CaptnSisko/CHARM/notebooks/trevor/README.md

# Lab Notebook

Trevor Wong (txwong2)

## Structure

This markdown file represents a summary of the work I've completed for this project. Each of the sections below represent a notebook entry. Based on the [online rubric](https://courses.physics.illinois.edu/ece445/guidelines/lab-notebook.asp), each entry must contain the following:

1. Date
2. Brief statement of objectives for session
3. Record of what was done

## 2022.08.23

We had our first group meeting. Our goal was to brainstorm ideas and come up with a high-level project idea that would be fun, useful, and fulfill the class requirements.

We came up with the idea of a drone-deployable mesh network and wrote a [post](https://courses.physics.illinois.edu/ece445/pace/view-topic.asp?id=71252) about it. We explored related research papers ([1](https://www.researchgate.net/publication/324776287_Drone_Based_Wireless_Mesh_Network_for_DisasterMilitary_Environment
) [2](https://ieeexplore.ieee.org/document/8796743)) and existing products ([1](https://www.iwtwireless.com/en-us/markets/tunneling/mine-rescue) [2](https://gotenna.com/blogs/newsroom/helitracking-connects-french-search-and-rescue-team-members-using-gotenna-mesh)), but these solutions were either much more expensive than our proposed design or did not offer the same set of features.

## 2022.08.25

We had our second group meeting to discuss design details and assign specific tasks.

After the meeting, we assigned further research as follows:
 - Mellisa: Sensors
 - Trevor: Battery Management
 - Martin: Routing

For the rest of the day and part of the next day, I researched requirements for the BMS and how I could implement it. I found the following components that could be useful in our design:

- [Batteries](https://liionwholesale.com/collections/batteries/products/protected-f1l-3350mah-li-ion-18650-button-top-battery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) - These batteries are cost effective li-ion cells from a reputable seller that include a built-in protection circuit. While the protected cells are longer than normal ones, we should be able to integrate clips to the PCB that accomodate them.
- [Charging IC](https://ww1.microchip.com/downloads/aemDocuments/documents/APID/ProductDocuments/DataSheets/21823D.pdf) - This is a popular, safe, and widely-used charge controller for LiPo and LIon batteries. An integrated controller like this is likely lot safer than a custom solution, especially considering the time constraints of our project.
- [Buck converter IC](https://datasheet.lcsc.com/lcsc/1810262207_XI-AN-Aerosemi-Tech-MT2492_C89358.pdf) - I researched some other voltage regulators, but they did not provide sufficient current for our design. A buck converter would probably be the best way to provide 3.3v regulation from the battery output, and this IC seems like it would be fairly easy to implement.
- [Boost converter IC](https://datasheet.lcsc.com/lcsc/1811151539_XI-AN-Aerosemi-Tech-MT3608_C84817.pdf) - We would also need a boost converter to convert the 5v USB input to the 12v needed to charge the batteries.

This [blog post](https://circuitdigest.com/electronic-circuits/designing-an-advance-2s-li-ion-li-po-battery-charger-system-using-mcp73844-ic) was helpful in coming up with battery design ideas and learning more about battery charging.

Overall, these ICs all have reference designs in their datasheet that we can adapt to our needs. We will need to carefully design our PCBs to follow the guidelines layed out in the datasheet, provide decoupling and filtering components as necessary, and minimize wasted space. We also need to consider the easy of assembly, since we will likely be soldering these by hand. I summarized my findings in our draft of the RFA.

## 2022.08.26

We had another meeting today with the goal of finalizing and submitting the RFA.

We reviewed our individual work and collaboratively submitted an RFA.

## 2022.08.29

We had a meeting to discuss next steps.

We decided to begin delagating tasks and decided to start working on the monitoring frontend / backend, since that part of our project is largely independent of hardware. I was assigned to create a task board in Github, write boilerplate code for our frontend / API, and set up the cloud infrastructure.

## 2022.08.30

Today I worked on setting up the cloud infrastructure for my team.

For the frontend, I created a react template using `create-react-app`. Next, I set up a project on [Netlify](https://www.netlify.com/). I was already failiar with this CI/hosting platform, and it seemed like the easiest way to deploy our frontend for free. The biggest challenge I ran into was figuring out how to configure the automatic deployment. Considering the master branch might have a large number of commits that don't relate to the frontend, I decided to create a `client-deploy` branch specifically for the netlify integration. Now, to deploy the frontend, we simply open a pull request to the `client-deploy` branch. Netlify automatically generates a preview and publishes the changes to production when we approve the pull request. Netlify can also store secrets such as API keys as environment variables. This will be useful for interacting with Google maps.

For the backend, we decided to use an [AWS Lightsail](https://aws.amazon.com/lightsail/) instance. I installed NodeJS, MariaDB, Nginx, and LetsEncrypt and wrote some sample code to make sure the server worked. I added all team members' SSH keys.

## 2022.09.02

Today we had a team meeting to discuss progress and assign more tasks. 

## 2022.09.03 - 2022.09.05

Over the long weekend, I worked on the schematic for our nodes. The overall node design is split into 2 parts, each of which contain multiple submodules:

Charging circuit: `USB-C Charger input (5v) -> boost converter (9.6v) -> battery charger`

Omega2S circuit: `battery output (~7.4v) -> buck converter (3.3v) -> Omega2 and sensors`

There's a switch between the battery output and Omega2S circuit to allow the user to turn the device off when it is not in use or charging.

### Schematic

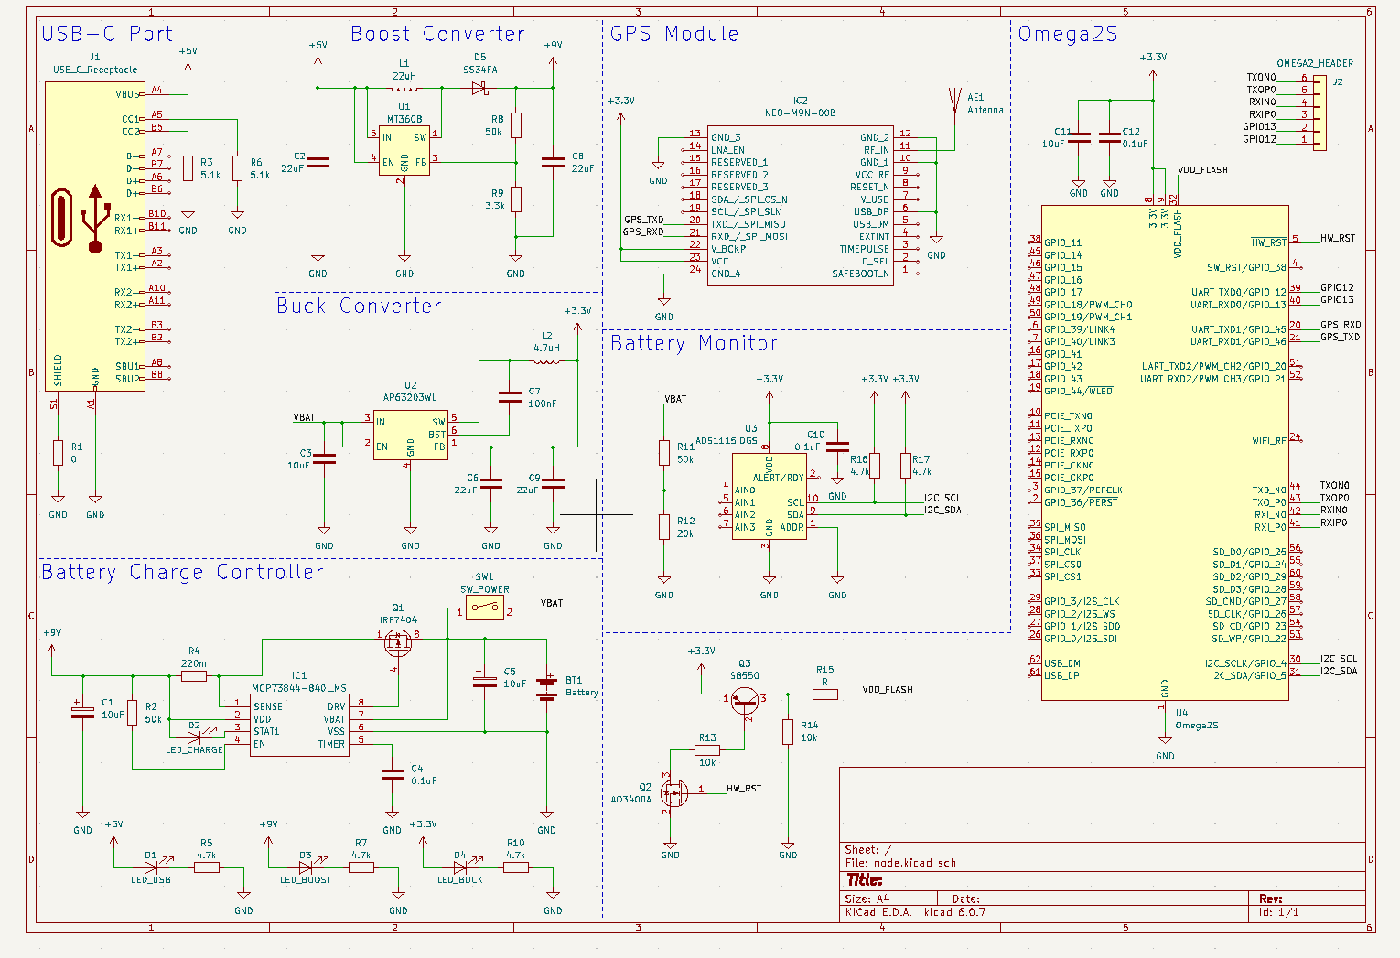
[picture p5: notebooks/trevor/images/draft1_schem.png]
CHARM Schematic


Notes on each component:

### USB-C Port

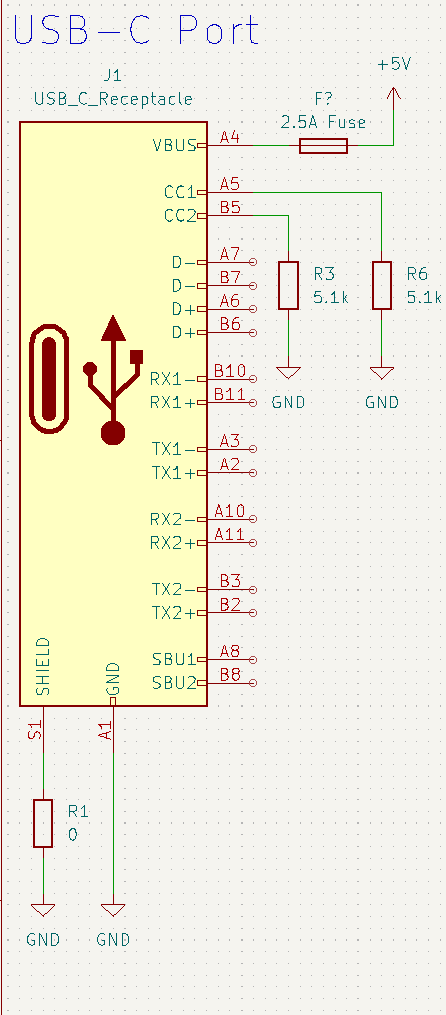
[picture p6: notebooks/trevor/images/draft1_usb.png]
CHARM Schematic USB-C USB-C Schematic


- Biggest challenges are power negotiation and soldering a 24-pin usb-c connector
- [It's possible to draw power from USB-C without negotiating on the CC pins with only two resistors](https://forum.digikey.com/t/simple-way-to-use-usb-type-c-to-get-5v-at-up-to-3a-15w/7016), which is by far the easiest and cheapest way to implement USB-C power delivery
- Our design is unlikely to draw 3 amps of power
- The tradeoff is that users with unsupported/legacy usb chargers may experience issues, and our design should only be used with usb power supplies that support at least 2.4 amps at 5 volts
- A fuse helps to mitigate safety hazards from accidental short circuits or other malfunctions causing current to be overdrawn
- For ease of soldering, CUI devices has [power-only USB-C connectors](https://www.mouser.com/pdfDocs/intro-to-power-only-usb-type-c_mouser.pdf) with fewer pins
- There are [mixed messages](https://electronics.stackexchange.com/questions/389972/usb-shield-to-ground-or-not-to-ground) about whether to ground the USB sheild, so a 0Ω resistor will allow us to change it either way as needed

### Boost Converter

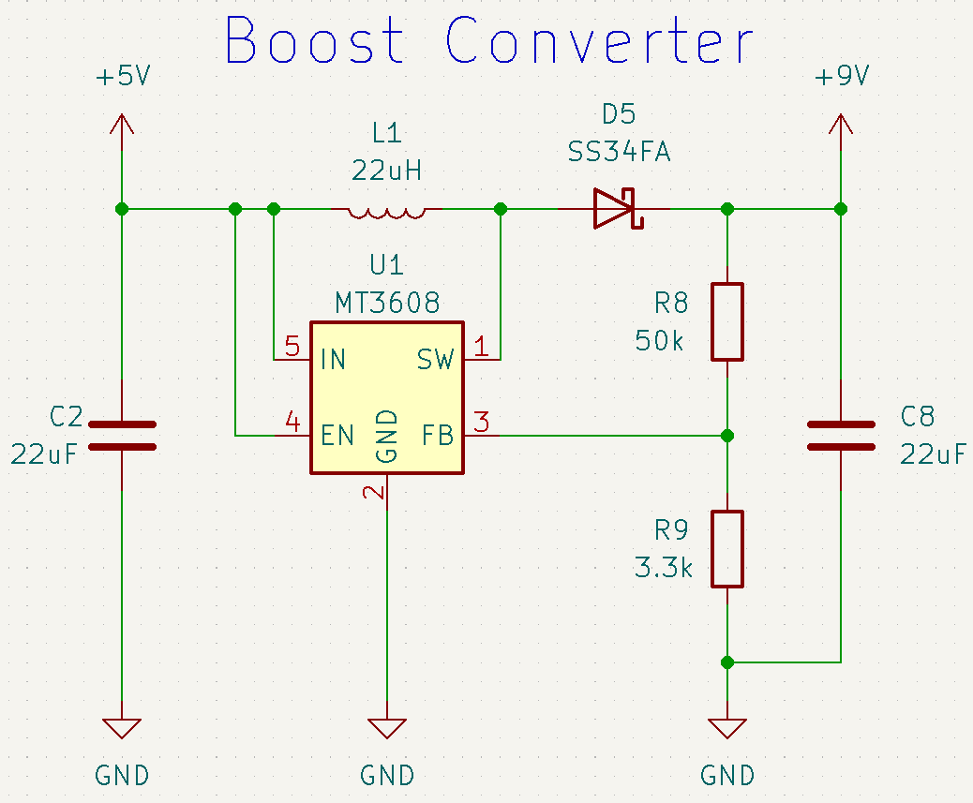
[picture p7: notebooks/trevor/images/draft1_boost.png]
CHARM Schematic Boost Converter Boost Converter Schematic

- MT3608 is an extremely popular boost converter, having been used in this [blog post](https://circuitdigest.com/electronic-circuits/designing-an-advance-2s-li-ion-li-po-battery-charger-system-using-mcp73844-ic) referenced earlier and many [cheap 2A boost converters on Amazon](https://www.amazon.com/Converter-Adjustable-Voltage-Regulator-Compatible/dp/B089JYBF25)
- The biggest change to the "standard" design (aka the reference schematic in the datasheet with the components all the breakout board sellers use) is this one uses a fixed resistor instead of a potentiometer for R8
- A fixed resistor lowers cost and footprint
- As long as the output voltage stays between 8.7 and 12, it is in spec as the input for the battery charge controller, which is all that really matters. This is such a wide range that a potentiometer for percise control is not needed

According to the MT3608 datasheet, the formula for output voltage is 

`Vout = Vref * (1 + R8/R9)`

Vref is typically 0.6V, with a range of 0.588V to 0.612V. If we use resistors with 1% tolerance, then R8 ranges from 49.5kΩ to 50.5kΩ and R9 ranges from 3.267kΩ to 3.333kΩ. Plugging these values in, we have

`min(Vout) = 0.588 * (1 + 49.5 / 3.333) = 9.32v`

`avg(Vout) = 0.6 * (1 + 50 / 3.3) = 9.69v`

`max(Vout) = 0.612 * (1 + 50.5 / 3.267) = 10.1v`

These are all within the acceptable range for our application. 

- The datasheet suggests using inductors from 4.7 to 22 uH. All the MT3608 boost converter breakout boards I've seen on [Aliexpress](https://www.aliexpress.com/wholesale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), Amazon, etc seem to use a 22 uH inductor, so I selected that value for the inductor 
- The datasheet suggests 22uF capacitors with low ESR, specifically stating X5R and X7R types are preferred
- The datasheet suggests a Schottky diode with a referse breakdown voltage higher than the output voltage and a current rating determined by the formula as follows:
- This chip seems difficult to source standalone in the USA, although it is available on JLC PCB and AliExpress

`Id = sqrt(Iout * Ipeak)`

Iout = 0.5, which is the typical charge current for our battery
Ipeak = 2, which is the absolute maximum the battery charging circuit should draw

According to this formula, we should use Schottky diode with a rating of at least 1A. The [SS34](https://www.mouser.com/ProductDetail/onsemi-Fairchild/SS34FA?qs=R26iFe%2FkX%2FK1QUwZdCmBBw%3D%3D) is the most commonly used diode in the premade PCBs online, and this is rated for 3A of current, a 40V breakdown voltage, and a low forward voltage of 0.5V. The current rating might be overkill for our use case, so it might be worth considering alternatives such as the [SS22FA](https://www.mouser.com/ProductDetail/onsemi-Fairchild/SS22FA). It is unclear whether there are any major downsides to using a diode rated for a higher current than what is actually used, and selecting the most widely used component might be the safest option.

### Buck Converter

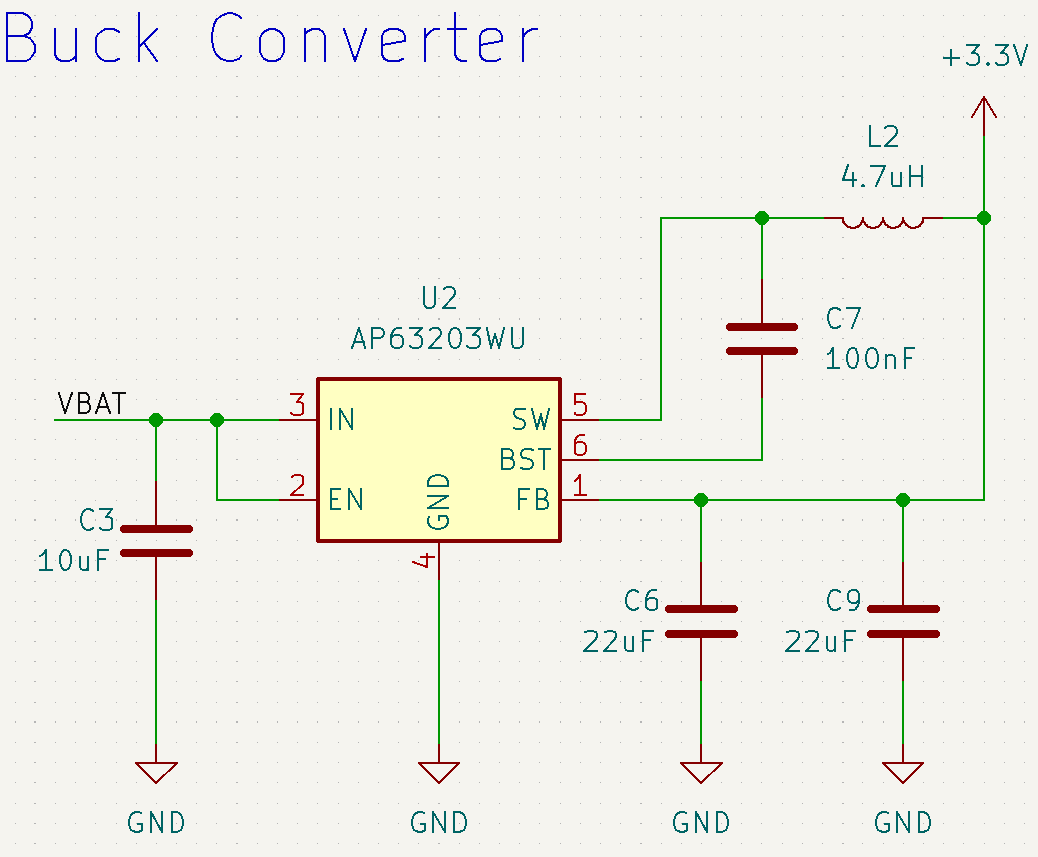
[picture p8: notebooks/trevor/images/draft1_buck.png]
CHARM Schematic Buck Converter Buck Converter Schematic


- A voltage regulator is needed to step down the battery voltage to 3.3V for the processor and sensors
- Linear voltage regulators are generally rated for 800mA or less, which would be enough for the Omega2S alone but not for also powering the GPS and ADC
- Using an external antenna on the GPS and Omega2S might also increase the power draw beyond what a linear regulator could provide
- An unstable 3.3v supply could cause reliability issues which are unacceptable in a search and rescue mission
- a buck converter can achieve higher efficiency and much higher current capacity
- the [AP63203WU](https://www.mouser.com/ProductDetail/Diodes-Incorporated/AP63203WU-7?qs=u16ybLDytRZ1JqxbuLkMJw%3D%3D) has an internal 3.3v reference voltage, so there is no need to set external resistor values like with the boost converter
- This buck converter can supply up to 2A, which is plenty
- the passive component selection and layout is identical to the reference schematic provided in the datasheet

### Battery Charge Controller

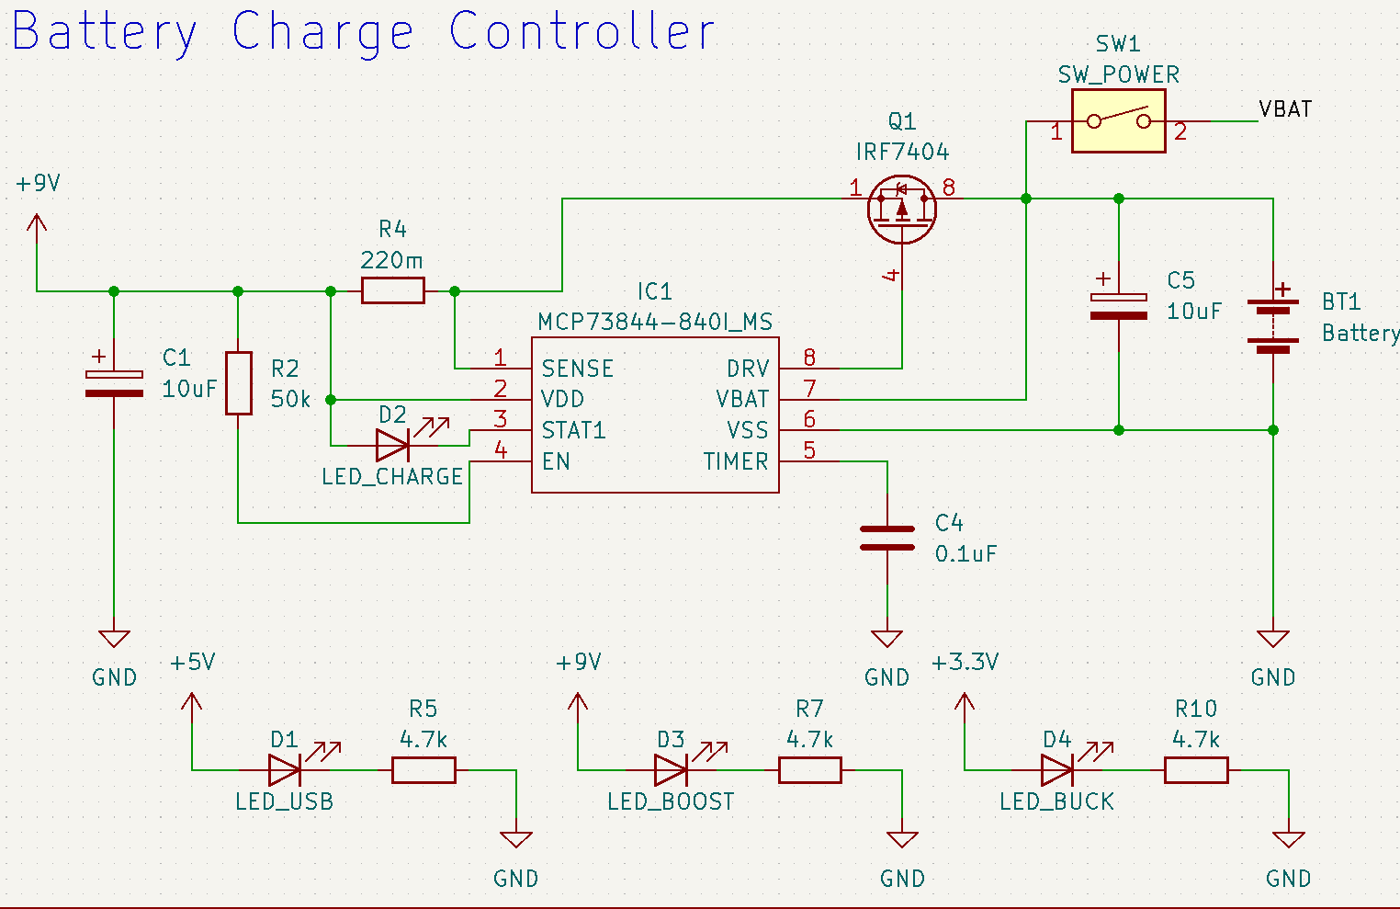
[picture p9: notebooks/trevor/images/draft1_bcc.png]
CHARM Schematic Battery Charge Controller Battery Charge Controller


- This implementation follows the reference schematic for the [MCP73844](https://www.mouser.com/ProductDetail/Microchip-Technology-Atmel/MCP73844-840I-MS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)
- This chip is specifically designed for 2s LiIon batteries with a maximum charge of 4.2V
- The NDS8434 and IRF7404 are both recommended as MOSFETS. The NDS8434 is not stocked on mouser, so I used IRF7404
- The datasheet recommends at least a 4.7uF tantalum or aluminum electrolytic capacitor at the power source and in parallel to the battery for up to 1A of charging current. 10uF allows for additional error margin, and it is the value used in the "typical application circuit" on the datasheet
- The enable pin simply needs to be pulled high, so the exact resistor value doesn't matter too much. 50k is used because it is already present in other parts of the design
- Arguably the most important passive component is the shunt resistor, as this determines the charge current. The datashee specifically recommends the ERJ-6RQFR22V 220 mΩ, 1%, 1/8W shunt resistor for approximately 500mA charging. The formula for the resistor value is as follows:

`Rsense = Vfcs/Ireg`

Vfcs is the Fast Charge Current Regulation Threshold, which ranges from 0.1v to 0.12v with a nominal value of 0.11v according to the datasheet.

Ireg is the desired charging current, in amps.

Since we want 500mA charging, Rsense = 0.11/0.5 = 0.22 or 220mΩ. Given the resistor has a 1% tolerance, we can also calculate the minimum and maximum charge current as follows:

`min(Ireg) = 0.1/0.2222 = 0.45 = 450mA`

`max(Ireg) = 0.12/0.2178 = 0.551 = 551 mA`

These are all acceptable currents for our application. Our batteries have 3400mAh of capacity, so a safe 1C charging speed would be anything up to 3.4 Amps of current. That said, it is important to limit the current to not overload the USB power source and allow for lower capacity batteries to be safely used.

The power dissapated over the resistor is given by

`P = R * I^2`

Given a worst case current of 551mA, the resistor disapates up to 66.8mW of heat, which is within spec of the suggestion above and a reasonable value.

This calculation matches that made in the datasheet, so their shunt resistor recommendation holds for our use case.

- A 0.1uF capacitor on the timer pin results sets the battery safety timers to their default value
- TODO: check if a larger capacitor is needed to increase the safety timers, since the cells we are using have such a high capacity that they will take over 3 hours to charge
- The schematic includes the status LED and also LEDs on the power rails that can double as test points

### GPS Module

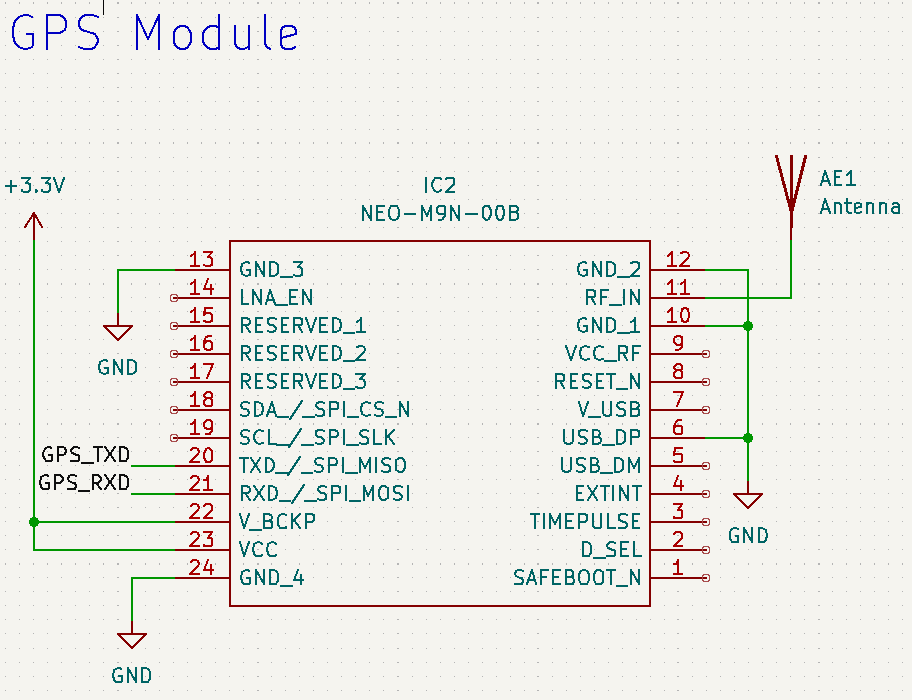
[picture p10: notebooks/trevor/images/draft1_gps.png]
CHARM Schematic GPS Module GPS Module


- The [NEO-M9N](https://www.u-blox.com/en/product/neo-m9n-module) GPS is one of the latest GPS modules from U-blox, with a high level of accuracy considering the cost
- It supports the standard NEMA protocol over UART
- Doesn't seem to have an antenna, so a port will need to be added to the PCB
- Sparkfun sells a [breakout board](https://www.sparkfun.com/products/15712) and a number of compatible [GPS antennas](https://www.sparkfun.com/search/results?term=U.FL+antenna). The breakout board schematic is open source, so it can be used for reference
- The implementation of this chip is extremely simple, with no required passive components other than an antenna
- TODO: figure out for sure whether it has a built in antenna
- TODO: does this need a decoupling capacitor or other passive components

### Battery Monitor

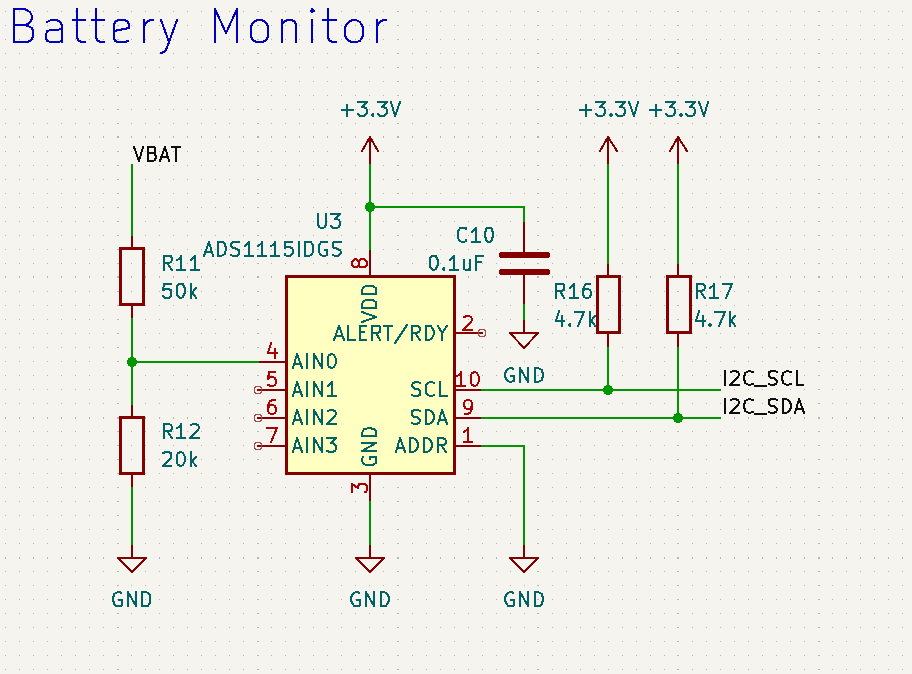
[picture p11: notebooks/trevor/images/draft1_bm.png]
CHARM Schematic Battery Monitor Battery Monitor


- The [ADS1115](https://www.ti.com/product/ADS1115) is the ADC used in the official breakout board for the Omega2, so it makes sense to use here
- According to the Omega2S docs, the I2C wires should both have 4.7k pullup resistors
- The dastasheet suggests a 0.1uF decoupling capacitor
- The battery voltage is sent through a voltage divider, since the analog voltage can only be read from GND-0.3 to VDD+0.3, which is -0.3v to 3.6v in this case
- With the voltage divider, a fully charged battery at 8.4 volts would read as 2.4v
- 50k resistor is used because it is present in other parts of the circuit, and high resistance minimizes wasted current

### Omega2S

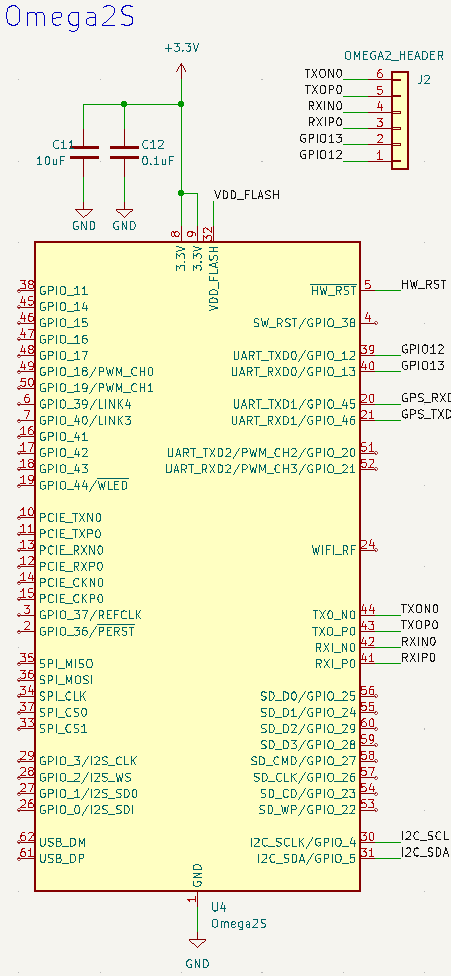
[picture p12: notebooks/trevor/images/draft1_omega.png]
CHARM Schematic Omega2S Omega2S


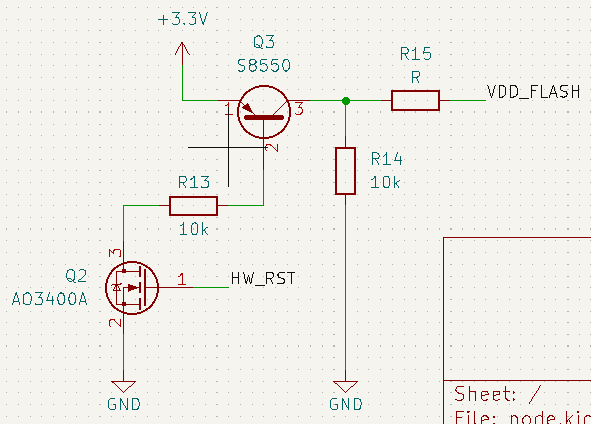
[picture p13: notebooks/trevor/images/draft1_omega_power.png]
CHARM Schematic Omega2S Omega2S


- Not much to say, this schematic is the suggested implementation from the [official hardware design guide](https://github.com/OnionIoT/Omega2/blob/master/Documents/Omega2S%20Hardware%20Design%20Guide.pdf)
- TODO: verify the test points can be used to flash the omega2 if it become currupted (doesn't it need a ground pin or something?)
- TODO: determine if we are using Omega2S or Omega2S+, which changes the power-on circuit
- TODO: determine if there are any more metrics that should be monitored by the ADC or if the device needs any other ports such as USB or Ethernet

## 2022.09.05

We had a meeting to discuss the current design and check the pricing and availability of the components.

It turns out many of the components in the design are out of stock or difficult to obtain in the USA. I was assigned the task of redoing the boost and buck converter with new ICs. The Omega2S is also being replaced with an Omega2+ to allow for a more modular design.

We found [this boost converter](https://www.mouser.com/ProductDetail/595-TPS61085TPWR) and [this voltage regulator](https://www.mouser.com/ProductDetail/595-TPS61085TPWR) that should be able to replace the out of stock parts.

## 2022.09.10

Today I am updating the circuit to only include in-stock ICs.

The [boost converter found in the last meeting](https://www.ti.com/product/TPS61085T) only supports 6v input, so I guess it's back to the drawing board. Looking online, I found a lot of boost converter PCBs use the [XL69019](http://www.xlsemi.com/datasheet/XL6019%20datasheet-English.pdf), but unfortunately this also has limited availability.

Using the [Texas Instruments webench tool](https://webench.ti.com/power-designer/) to design boost and buck converters. This took a long time, since I went through each passive component to find ones that were all in stock. Eventually, I was able to generate two schematics that worked for out design, and I transcribed them to KiCad as shown below:

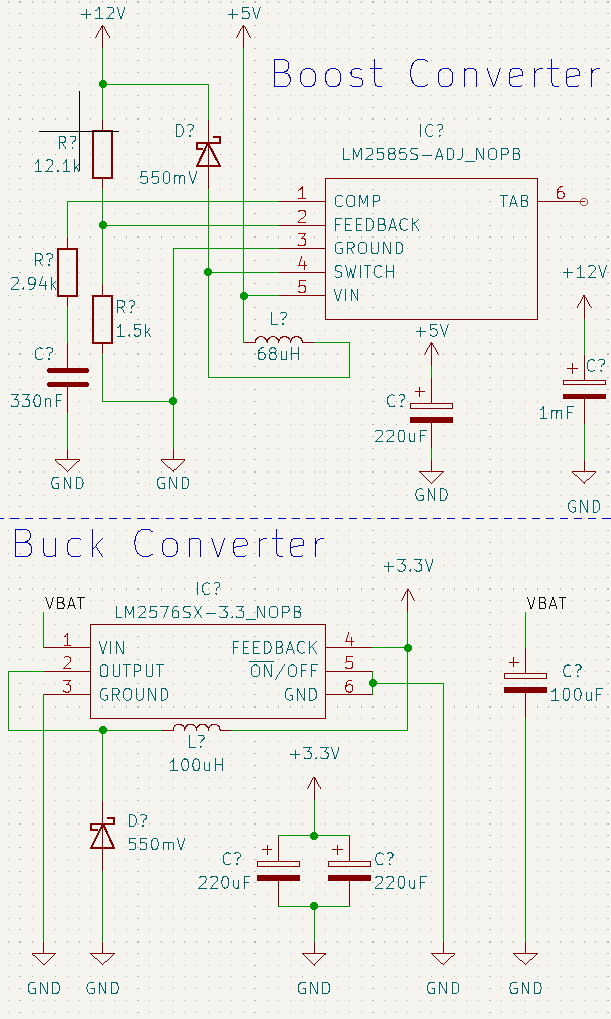
[picture p14: notebooks/trevor/images/instock_converter.png]
Updated Schematic Buck and boost converter


This design uses the [LM2576](https://www.ti.com/lit/ds/symlink/lm2576.pdf?ts=1662810343921) buck converter and [LM2585](https://www.ti.com/lit/ds/symlink/lm2585.pdf?ts=1662839934079) boost converter.

## 2022.09.10

This morning, I discovered TI had a fixed voltage output variant of the boost converter I was using.

I used the webench tool to help design a new boost converter with even lower BOM count, changing a few components to ensure each part was in stock on Mouser.

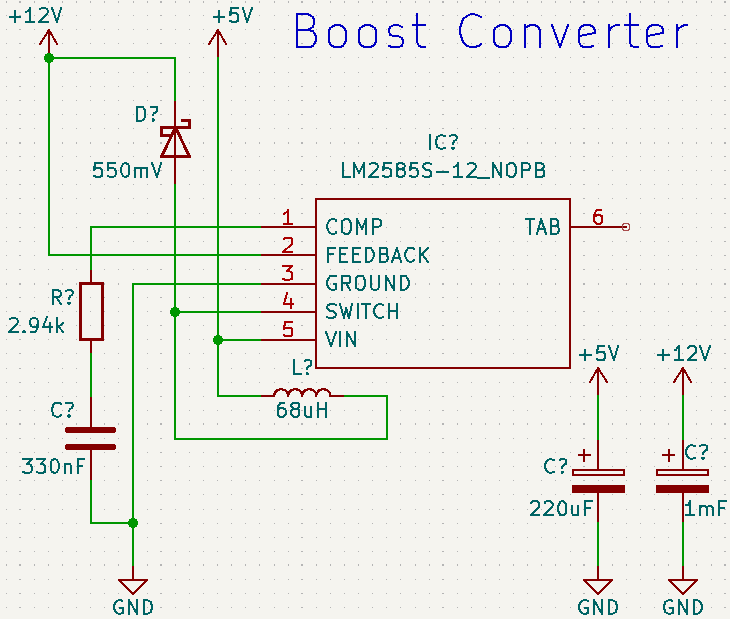
[picture p15: notebooks/trevor/images/updated_boost.png]
Low-part boost converter Boost converter


As shown, the design is largely unchanged, but there is no need for a voltage divider to provide feedback like there was before.

## 2022.09.13

Today, I am uploading the design reports I generated using the TI Webench tool a couple days ago.

[Boost Converter Design Report](files/Boost_Converter_Design_Report.pdf)

[Buck Converter Design Report](files/Buck_Converter_Design_Report.pdf)

## 2022.09.15

Today I finished and submitted my part of the proposal as well as revised my other teammates' sections. I mostly focused on power delivery. I also met with the machine shop with Melissa to discuss their role in the project. They are willing to pay for the PCB boxes and it won't be counted against our budget. 

## 2022.09.20 - 2022.09.25

This week, I continued double and triple checking the hardware schematic to ensure it would work when we ordered our first round of PCBs. The total BOM cost is fairly high for 5 nodes, so I wanted to make sure we would not waste our money on a bad board or incorrect components.

The biggest error in the schematic involved the UART port for the GPS. Specifically, the [Omega2S+ hardware design guide](https://github.com/OnionIoT/Omega2/blob/master/Documents/Omega2S%20Hardware%20Design%20Guide.pdf) requires the UART pins to be floating on bootup, which would not work with the GPS connected to these pins:

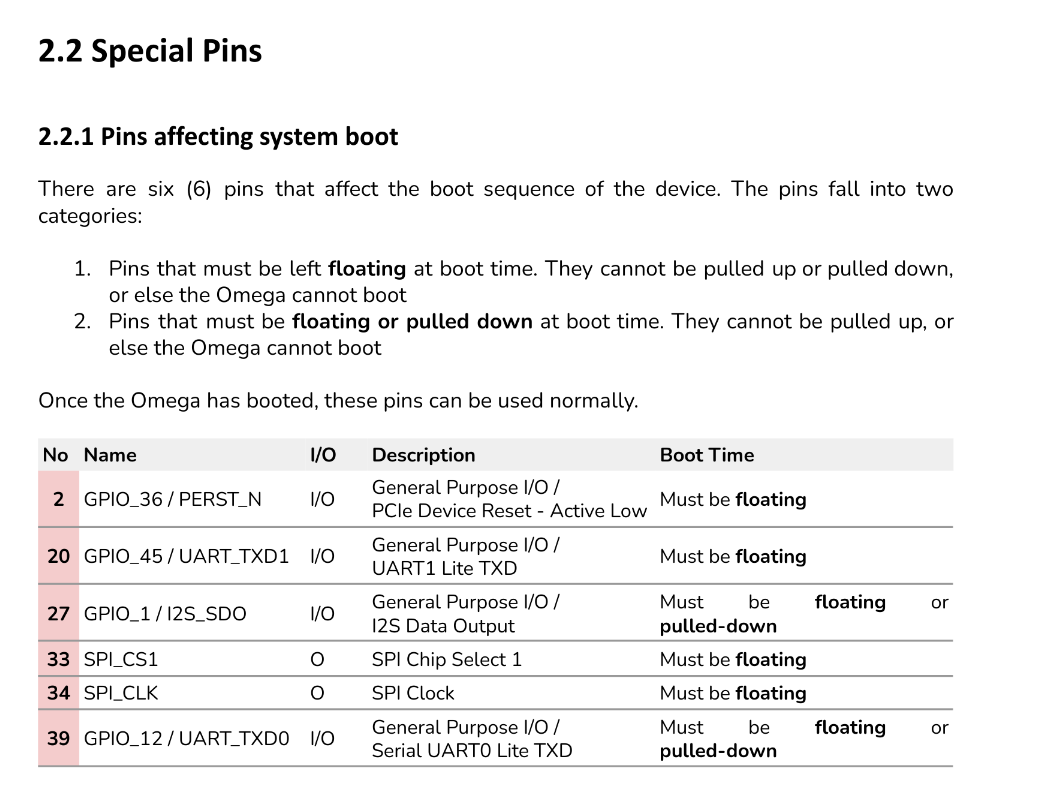
[picture p16: notebooks/trevor/images/revise_omega.png]
Omega Hardware Design Guide Floating UART


To fix this, I changed the GPS module to connect to the omega2s via USB. I also added series resistors on the data lines as specified in the GPS and Omega2S reference schematics.

I also revised the GPS antenna design to implement the bias-T circuit recommended in the hardware integration manual:

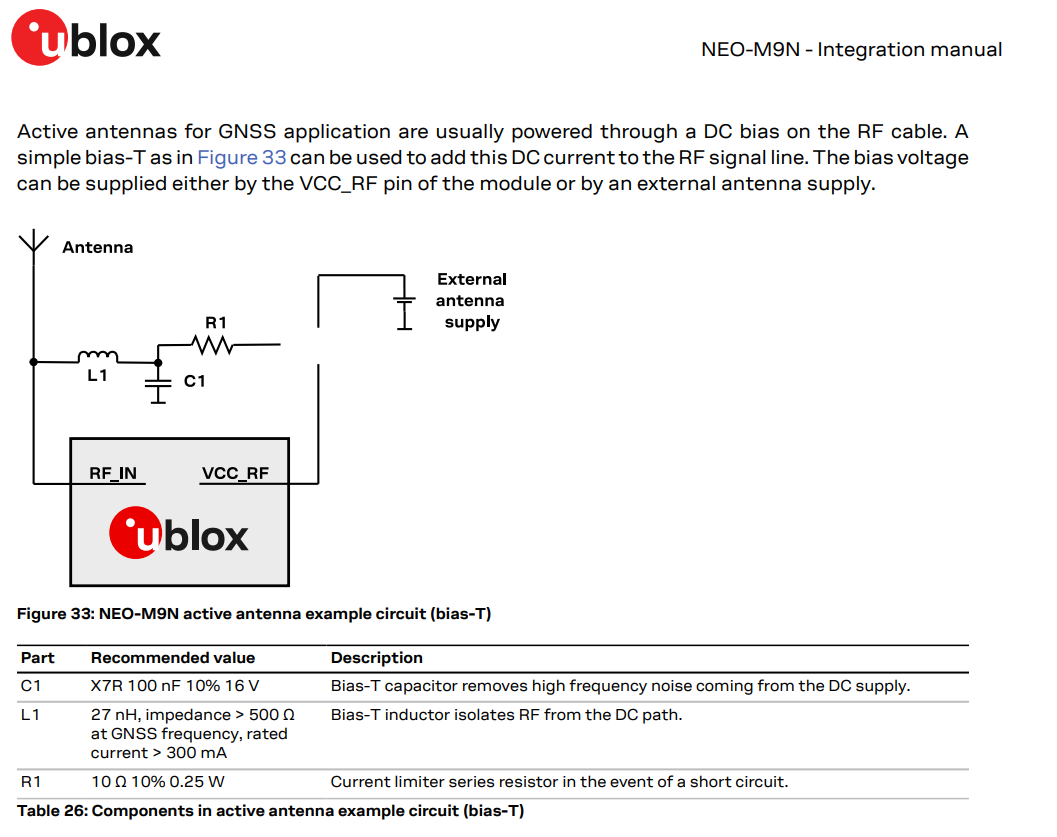
[picture p17: notebooks/trevor/images/revise_neo.png]
NEO-M9N Hardware Design Guide Active Antenna


I also added a decoupling capacitor and anti-ESD diode as recommended in the manual.

## 2022.09.27

I spent all day today going through every single schematic symbol, finding a compatible part on mouser, and assigning a footprint accordingly. When there was not a standard footprint available in Kicad I used [Component Search Engine](https://componentsearchengine.com/) to find footprints online. While there's not too much to say in the notebook, this was a long and tedious process.

## 2022.09.29 - 2022.10.4

I spend a few days completing the PCB layout and submitting the order to JLC PCB. Our design is too large for the course's 10cm by 10cm limit, and our TA advised us that the course PCB order would likely be delayed.

The submodules were arranged as follows:

### USB-C Port
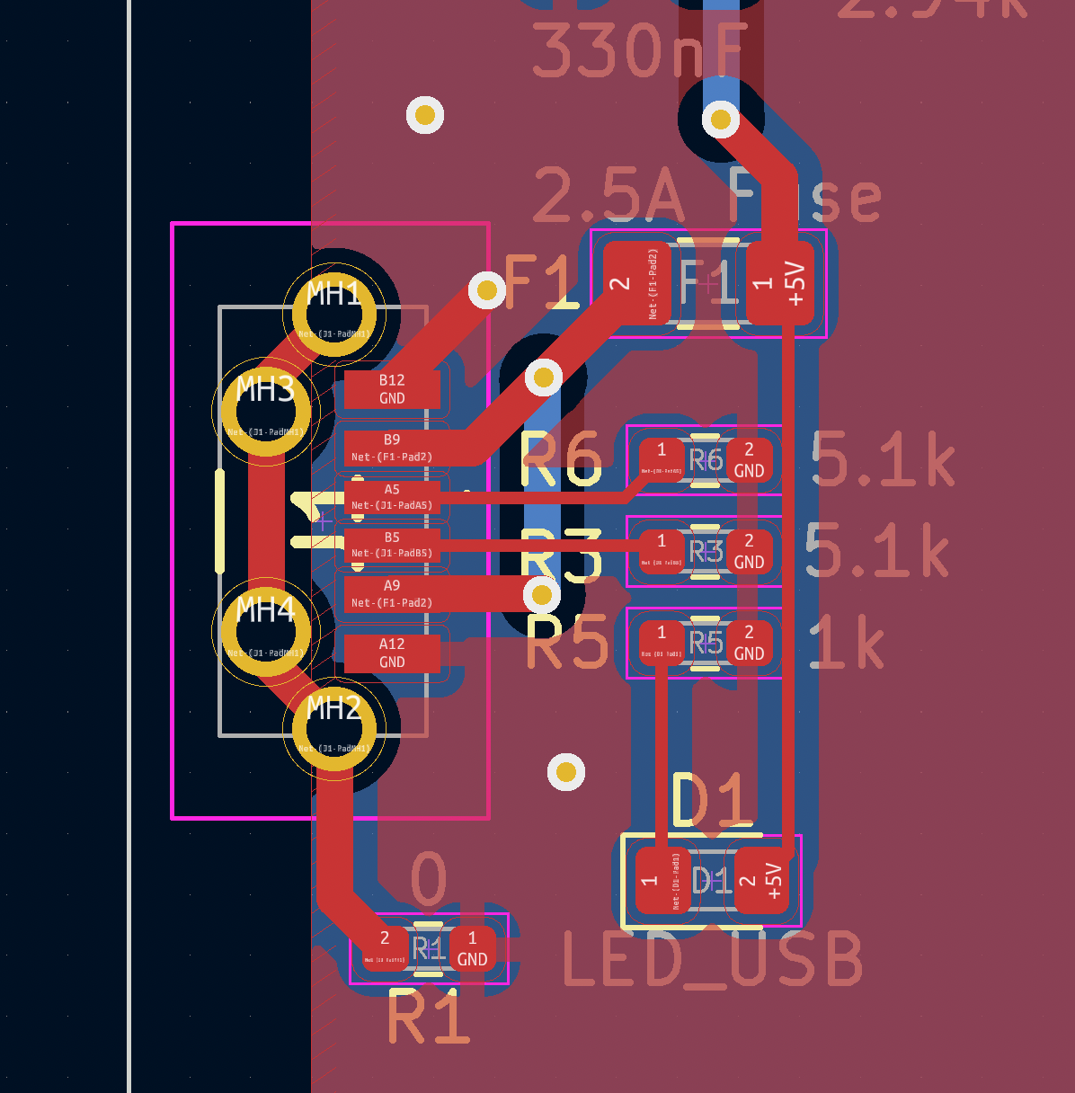
[picture p18: notebooks/trevor/images/layout1_usb.png]
CHARM Layout USB-C USB-C

Not to much to say about the USB-C layout. R1 will likely be left blank, but it can be easily added to ground the USB sheilding if needed. Large traces are used for 5v power delivery.

### Boost Converter

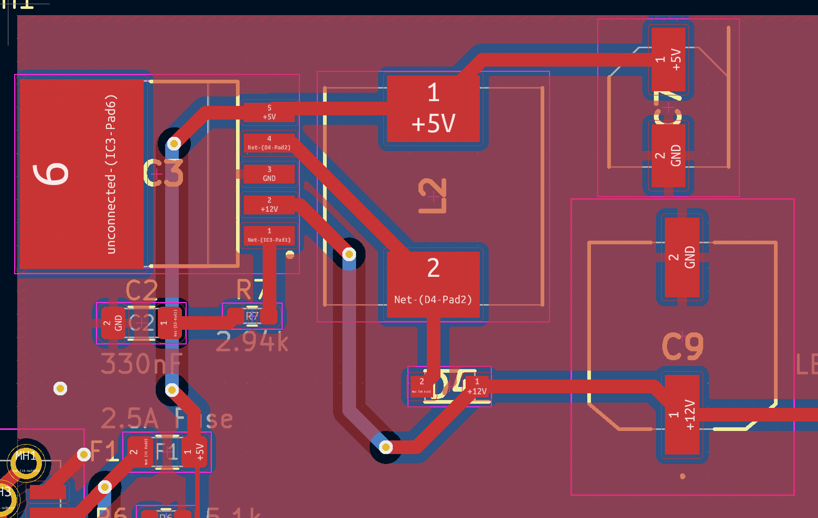
[picture p19: notebooks/trevor/images/layout1_boost.png]
CHARM Layout Boost Converter Boost Converter


This follows the recommended boost converter layout from the boost converter IC datasheet. Thick traces are used throughout since this is a power delivery circuit. 

### Battery Charge Controller

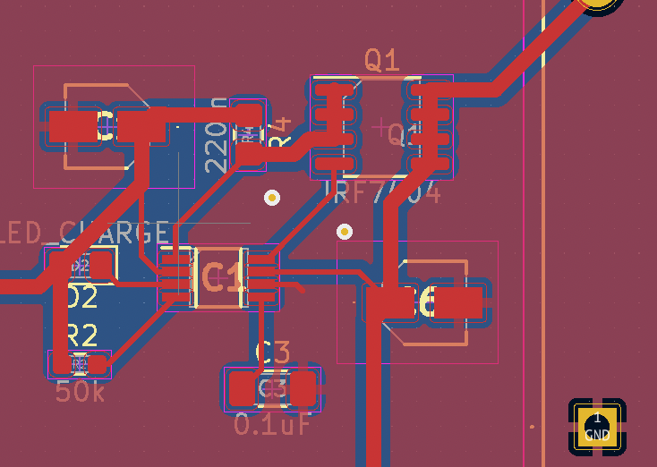
[picture p20: notebooks/trevor/images/layout1_bms.png]
CHARM Layout Battery Charge Controller Battery Charge Controller


This layout is similar to this [blog post](https://circuitdigest.com/electronic-circuits/). Large traces are used where the battery charging current is expected to flow. The pins on the battery charge controller are too narrow to use large traces everywhere.

### Buck Converter

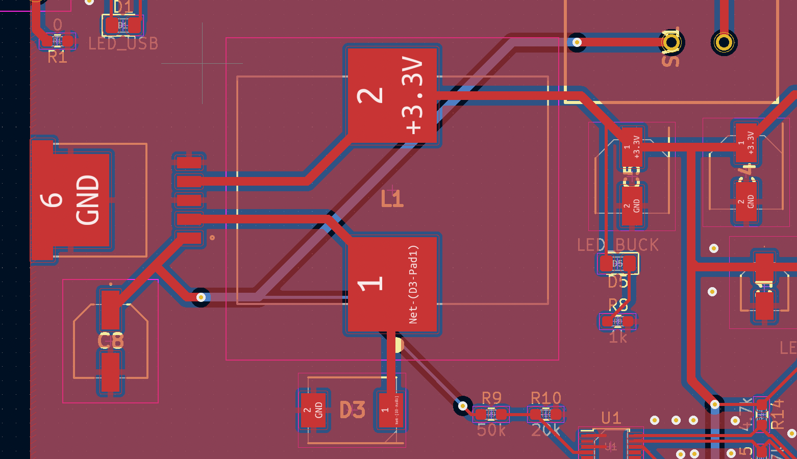
[picture p21: notebooks/trevor/images/layout1_buck.png]
CHARM Layout Buck Converter Buck Converter


This follows the recommended boost converter layout from the buck converter IC datasheet. Thick traces are used throughout since this is a power delivery circuit. I did not realize how large inductor L1 was until seeing its footprint. C4 and C5 are output decoupling capacitors for the buck converter, and other components on the right are for other subsystems.

### Omega2S

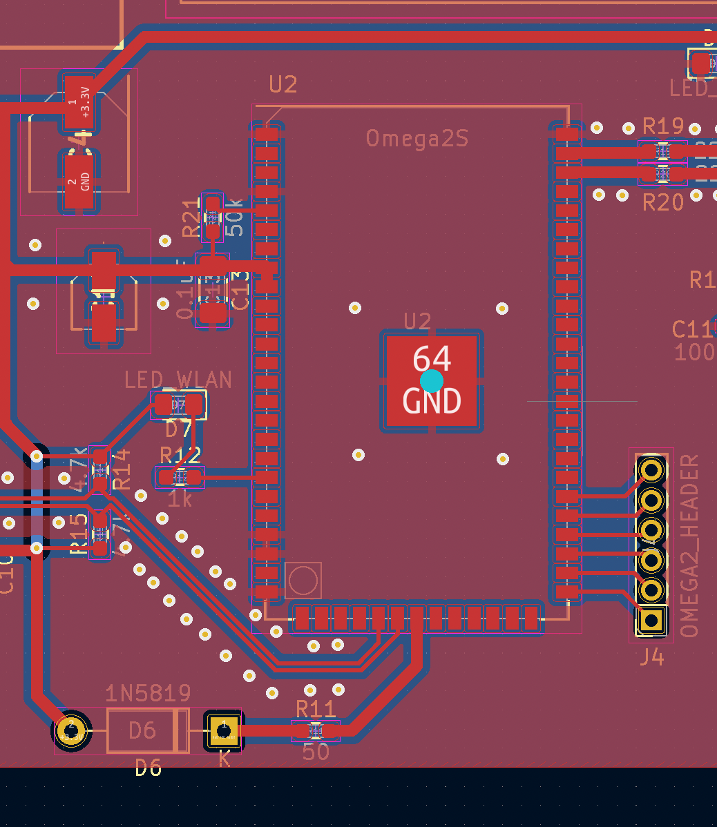
[picture p22: notebooks/trevor/images/layout1_omega.png]
CHARM Layout Omega2S Omega2S


The layout for the Omega2S is fairly simple, and most of my time was spent verifying which pins should be connected to power, pulled up, or grounded. There are two decoupling capacitors on the 3.3v rail, an exposed header for possible firmware flashing, and a diode for the flash power supply as specified in the [hardware design guide](https://github.com/OnionIoT/Omega2/blob/master/Documents/Omega2S%20Hardware%20Design%20Guide.pdf). Thick traces are used for power delivery.

### ADC

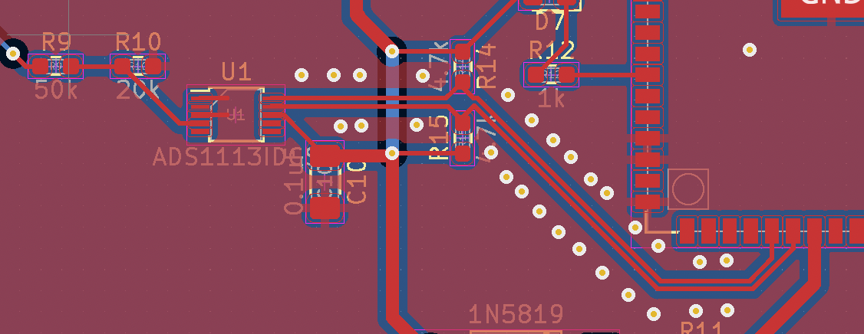
[picture p23: notebooks/trevor/images/layout1_adc.png]
CHARM Layout ADC Omega2S


The layout for the ADC includes the R9/R10 voltage divider, the C10 decoupling capacitor, and the R14/R15 pullup resistors. The data lines are impedance-matched by ensuring they are the same length and surrounded by ground vias to minimize signal noise. While this may be overkill for I2C, it is better to be safe than sorry.

### GPS

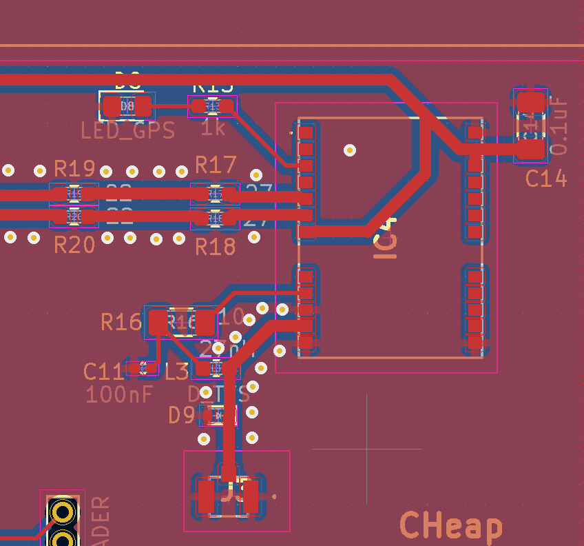
[picture p24: notebooks/trevor/images/layout1_gps.png]
CHARM GPS GPS


The GPS layout includes a decoupling capacitor, USB signal traces, and RF signal traces. The USB data lines have two sets of termination resistors, which are kind of silly but technically required to follow the reference schematic. Most likely, these will simply be populated with 0-ohm jumpers, but it is better safe than sorry. The bais-T circuit and ESD diode are on the bottom left. As recommended in the [NEO-M9N](https://www.u-blox.com/en/product/neo-m9n-module) design guide, the antenna trace is surrounded by grounding vias to minimize interference. The signal traces are thick to minimize impedance.

## 2022.10.15 - 2022.10.18

This weekend we soldered the first prototype PCB. Suprisingly, there is not much to say here, since all the subsystems worked as we tested them. There were a couple issues with the footprints and board dimensions, but overall we are quite happy with the PCB functionality.

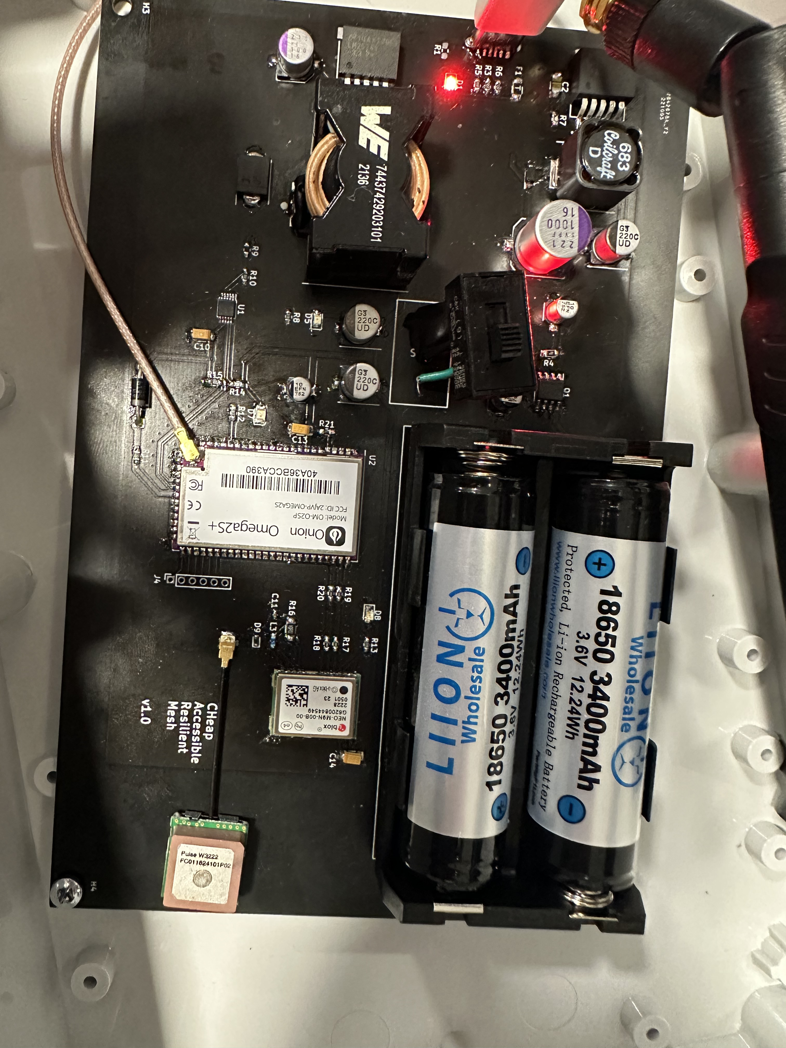
[picture p25: notebooks/trevor/images/pcb1_soldered.jpg]
CHARM PCB Revision 1 PCB Revision 1


### 2022.10.20

Today, I revised and ordered an updated PCB. The most visible change is the overall design, which now has rounded corners, rounded sides, and stylistic / weight saving triangle cutouts.

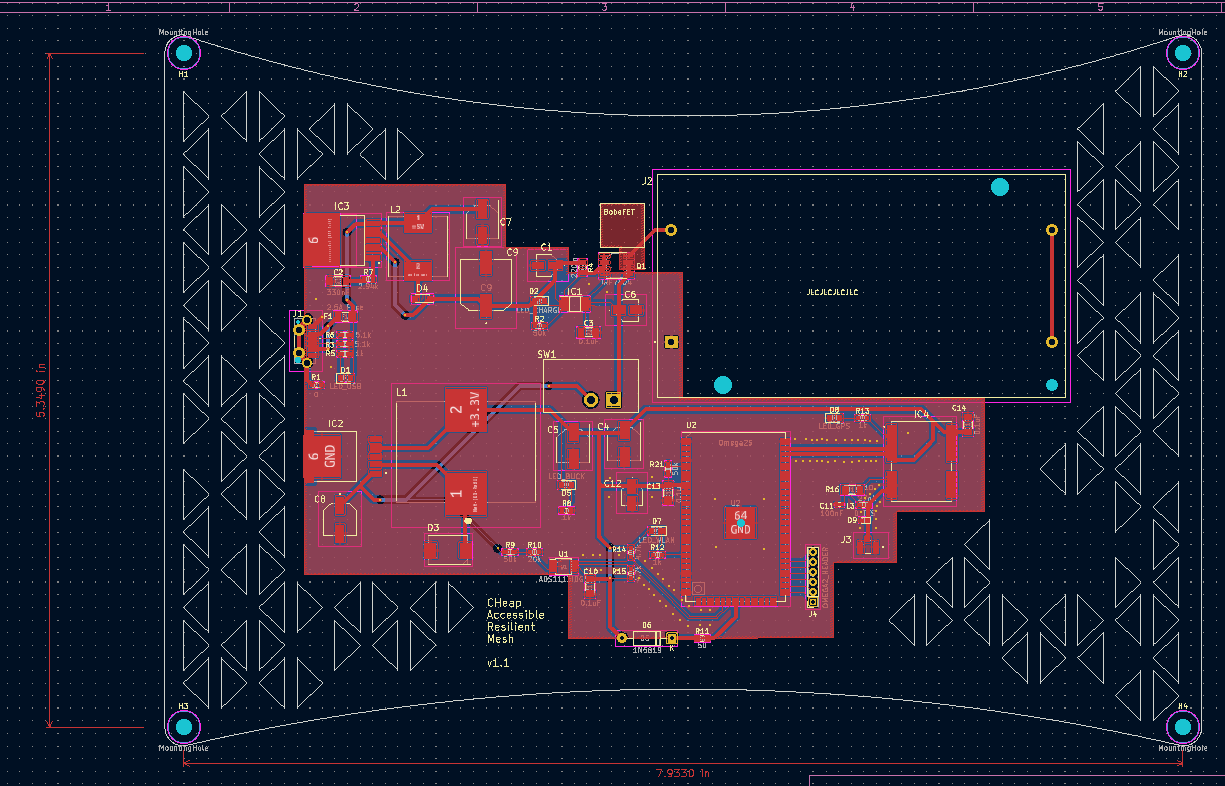
[picture p26: notebooks/trevor/images/layout2.png]
CHARM Layout Revision 2 Layout Revision 2


As shown in the screenshot, the battery footprint and USB footprint was corrected to include drill holes for the plastic supports. The holes for the switch were also moved and expanded. The ground plane was also refined to only cover the area that's needed, skipping unused parts of the board.

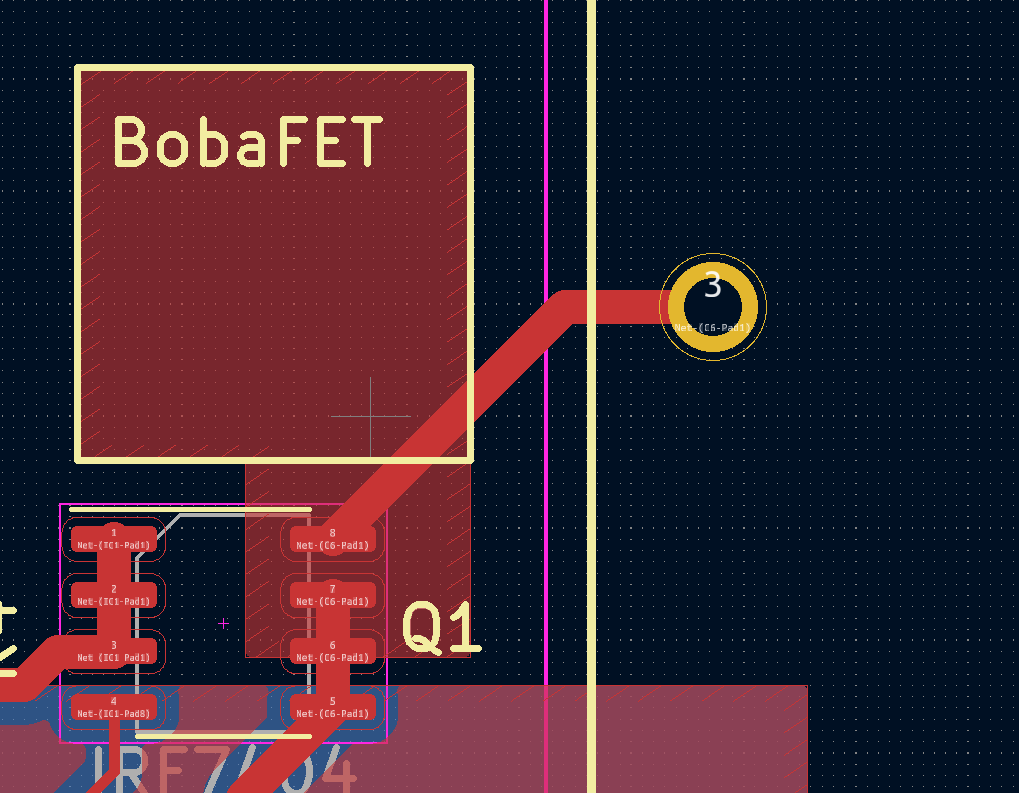
[picture p27: notebooks/trevor/images/layout2_heatsink.png]
CHARM Layout Revision 2 Heatsink Layout Revision 2 Heatsink


During testing, we found the battery charging MOSFET got very hot. I added this plane on the PCB to conduct the heat away from the chip. A heatsink will be placed on the plane to maximize heat dissapation.

### 2022.11.11 - 2022.11.13

I spend this weekend recompiling OpenWRT to ensure we have sensor support built in. The official [build system setup guide](https://openwrt.org/docs/guide-developer/toolchain/install-buildsystem) and [build system usage guide](https://openwrt.org/docs/guide-developer/toolchain/use-buildsystem) are extremely helpful. Instructions to recreate the image are below:

1) Set up all the required build tools.

I didn't want to bother making a virtual machine, so I just ran
```
sudo apt update
sudo apt install build-essential clang flex g++ gawk gcc-multilib gettext \
git libncurses5-dev libssl-dev python3-distutils rsync unzip zlib1g-dev
```
and everything worked fine (I am running Pop!_OS based on Ubuntu 22.04). If this does not work, follow the instructions above to make a virtual machine.

2) Clone the repository

```
git clone https://git.openwrt.org/openwrt/openwrt.git
cd openwrt
git pull
git branch -a
git tag
git checkout v22.03.2
```

3) Update the feeds

```
./scripts/feeds update -a
./scripts/feeds install -a
```

4) Apply the custom configuration

I've uploaded the configuration files necessary to compile an OpenWRT image that is compatible with our sensors. This took a very long time since there is not much documentation about the I2C drivers for the chip we are using. I tried to use a software i2c controller, but that didn't work either. [This forum post](https://forum.openwrt.org/t/mt7621-and-i2c-kmod-package/135136) was extremely helpful.

Download [.config](/code/node/compiling/.config) and place it in the root directory of the openwrt repository. Download [config-5.10](/code/node/compiling/config-5.10) and move it to `target/linux/ramips/mt76x8/config-5.10`. Finally, download [mt7628an_onion_omega2p.dts](/code/node/compiling/mt7628an_onion_omega2p.dts) and move it to `target/linux/ramips/dts/mt7628an_onion_omega2p.dts`.

5) Make additional config changes

These commands will open a GUI for selecting user-level packages and kernel-level packages. Do not deselect any USB or I2C packages, since they are required for the sensors to function.

```
make menuconfig
make -j $(nproc) kernel_menuconfig
```

6) Download source code for dependencies

Without this, multi-core compilation is likely to fail.

```
make download
```

7) Build the image

The following command will build the firmware image utilizing all CPU threads. You can open `build.log` with vscode or use a command like `tail -f build.log`. When I was building, it froze on an option asking whether to compile with pwm support. Typing `y` and pressing enter on the same terminal that ran the make command allowed the firmware image to build successfully. I am not sure why this prompt isn't answered automatically.

```
make -j $(nproc) V=s 2>&1 | tee build.log | grep -i -E "^make.*(error|[12345]...Entering dir)"
```

Once compilation is finished, the image should be located in `target/linux/ramips/mt76x8/openwrt-22.03.2-ramips-mt76x8-onion_omega2p-squashfs-sysupgrade.bin`.
