CaptnSisko/CHARM/notebooks/trevor/files/Boost_Converter_Design_Report.pdf

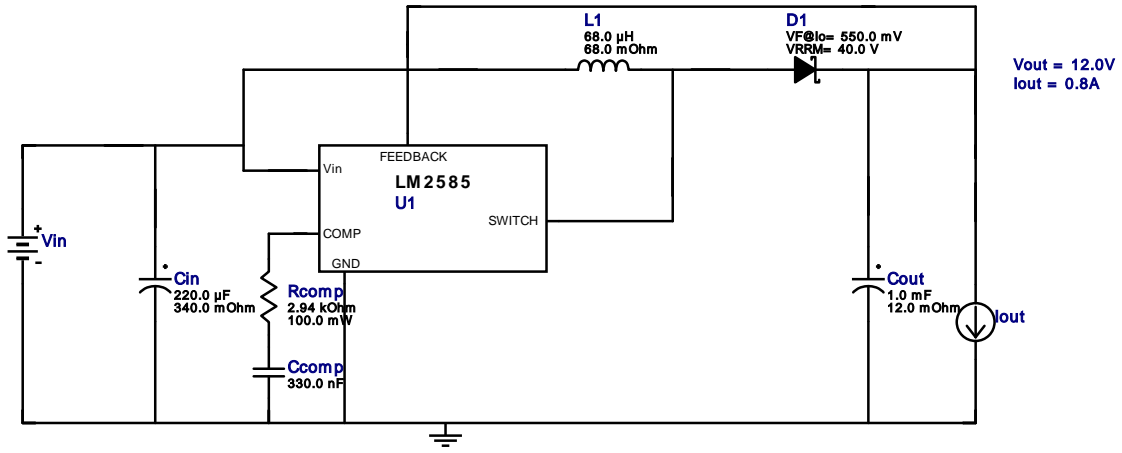
[picture p48: figure]
Cout 1.0 m F 12.0 m Ohm; L1 68.0 µH 68.0 m Ohm; Ccom p 330.0 nF; Rcom p 2.94 kOhm 100.0 m W; Vout = 12.0V Iout = 0.8A; Cin 220.0 µF 340.0 m Ohm; FEEDBACK; Vin; COMP; SWITCH; GND; D1 VF@Io= 550.0 m V VRRM= 40.0 V; Iout

Copyright © 2022, Texas Instruments Incorporated | 1 | ti.com/webench

WEBENCH®
Design Report LM2585S-12/NOPB : LM2585S-12/NOPB New Boost Converter September 11, 2022 17:51:48 GMT-05:00

## WEBENCH ® Design Report

Design : 4 LM2585S-12/NOPB
LM2585S-12/NOPB New Boost Converter

VinMin = 4.5V
VinMax = 5.5V
Vout = 12.0V
Iout = 0.8A

Device = LM2585S-12/NOPB
Topology = Boost
Created = 2022-09-11 11:26:06.993 BOM Cost = $6.72
BOM Count = 7
Total Pd = 2.64W

## Electrical BOM

Name | Manufacturer | Part Number | Properties | Qty Price | Footprint
Ccomp | Panasonic | ECPU1C334MA5 (http://industrial.panasonic.com/lecs/www%2Ddata/pdf/ABD0000/ABD0000CE12.pdf) Series= ECPU(A) | Cap= 330.0 nF VDC= 16.0 V IRMS= 0.0 A
1 | $0.23
| | | | | 1206 11 mm²
Cin | Nichicon | UUD1C221MCL1GS (http://products.nichicon.co.jp/en/pdf/XJA043/e%2Dud.pdf) Series= uD | Cap= 220.0 uF ESR= 340.0 mOhm VDC= 16.0 V IRMS= 280.0 mA
1 | $0.13
| | | | | SM_RADIAL_6.3BMM 80 mm²
Cout | Panasonic | 16SVPF1000M Series= SVPF | Cap= 1.0 mF ESR= 12.0 mOhm VDC= 16.0 V IRMS= 5.4 A
1 | $1.33

CAPSMT_62_F12 151 mm²
D1 | Fairchild Semiconductor SS24FL | VF@Io= 550.0 mV
VRRM= 40.0 V

1 $0.08
SOD-123F 12 mm²
L1 | Coilcraft | MSS1210-683MEB (http://www.coilcraft.com/pdfs/mss1210.pdf) | L= 68.0 µH 68.0 mOhm
1 | $0.81

MSS1210 204 mm²
Rcomp | Yageo | RC0603FR-072K94L (http://www.yageo.com/documents/recent/PYu%2DRC0603%5F51%5FRoHS%5FL%5F7.pdf) Series= ?

Res= 2.94 kOhm
Power= 100.0 mW
Tolerance= 1.0%

1 $0.01
0603 5 mm²

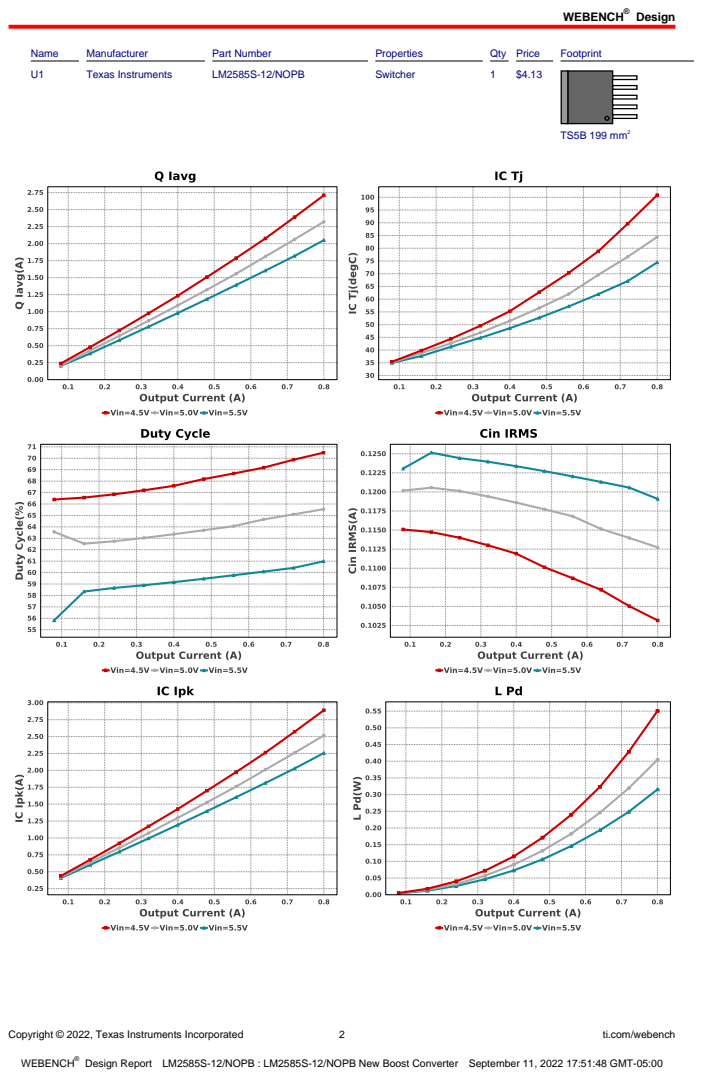
[picture p49: page 2]
Design; Copyright © 2022, Texas Instruments Incorporated; ti.com/webench; Name; Manufacturer; Part Number; Properties; Qty Price; Footprint; Texas Instruments; LM2585S-12/NOPB; Switcher; TS5B 199 mm²

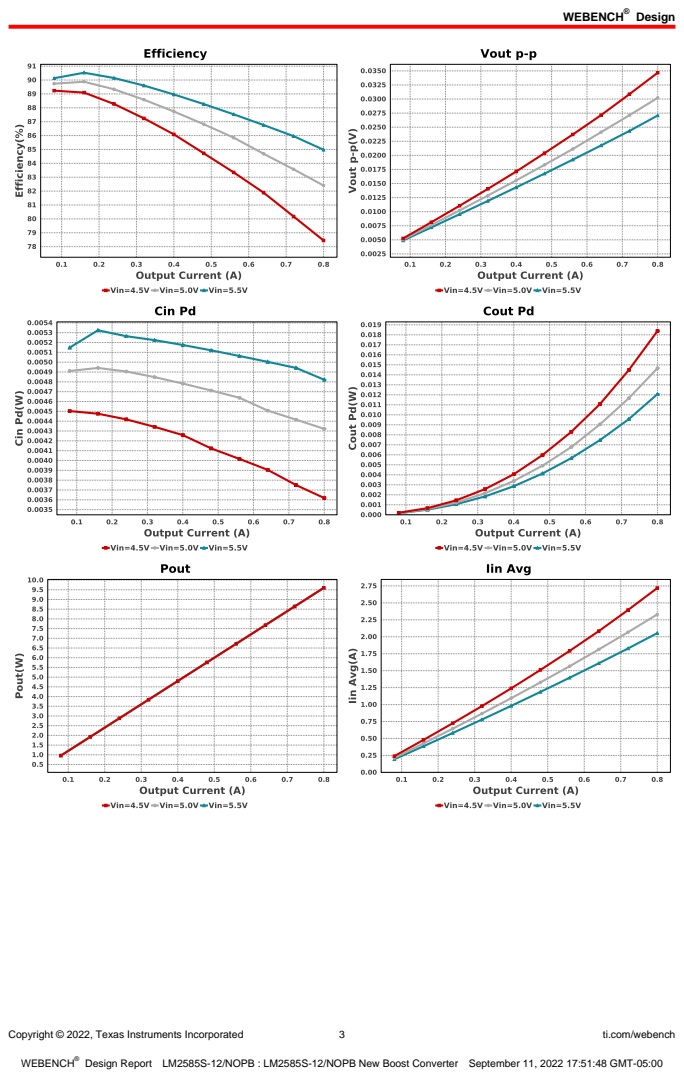
[picture p50: page 3]
Copyright © 2022, Texas Instruments Incorporated; ti.com/webench

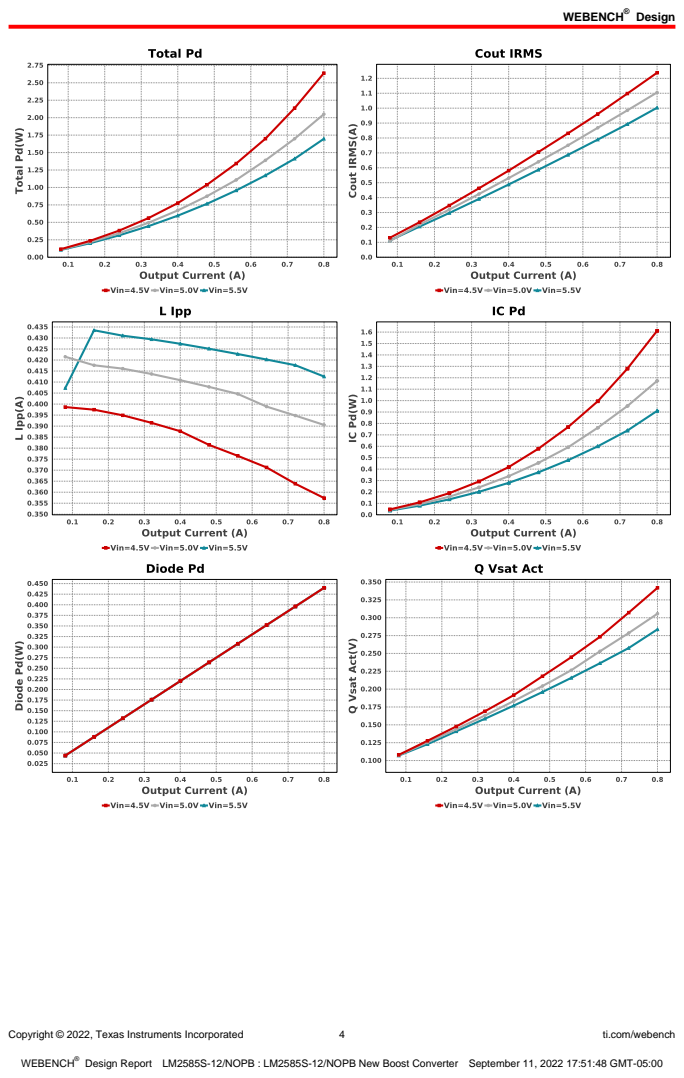
[picture p51: page 4]
Copyright © 2022, Texas Instruments Incorporated; ti.com/webench

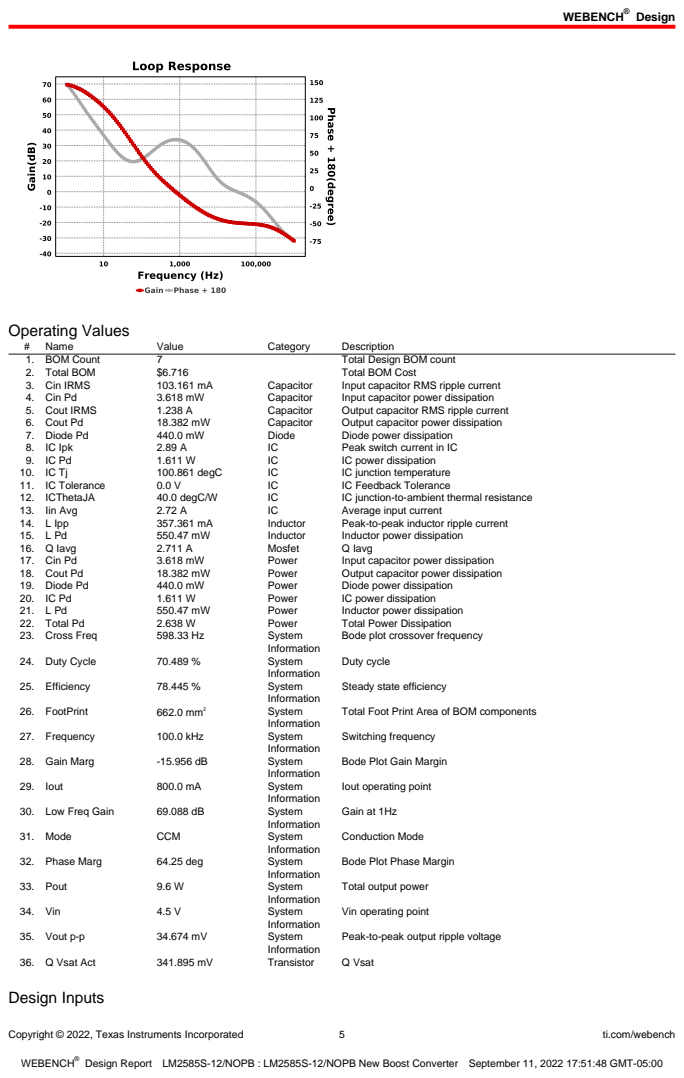
[picture p52: page 5]
Copyright © 2022, Texas Instruments Incorporated; ti.com/webench; Operating Values; Name; Value; Category; Description; 1. BOM Count; Total Design BOM count; 2. Total BOM; Total BOM Cost; 3. Cin IRMS; Capacitor; Input capacitor RMS ripple current; 4. Cin Pd; Input capacitor power dissipation; 5. Cout IRMS; Output capacitor RMS ripple current; 6. Cout Pd; Output capacitor power dissipation; 7. Diode Pd; Diode; Diode power dissipation; 8. IC Ipk; Peak switch current in IC; IC power dissipation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

Bode plot crossover frequency

Steady state efficiency

Total Foot Print Area of BOM components

Bode Plot Gain Margin

Iout operating point

Bode Plot Phase Margin

Total output power

Vin operating point

Peak-to-peak output ripple voltage

Copyright © 2022, Texas Instruments Incorporated | 6 | ti.com/webench
Name | Value | Description
Iout | 800.0 m | Maximum Output Current
VinMax | 5.5 | Maximum input voltage
VinMin | 4.5 | Minimum input voltage
Vout | 12.0 | Output Voltage
base_pn | LM2585 | Base Product Number
source | DC | Input Source Type
Ta | 30.0 | Ambient temperature


Copyright © 2022, Texas Instruments Incorporated | 7 | ti.com/webench

## Assembly

## Component Testing

Some published data on components in datasheets such as Capacitor ESR and Inductor DC resistance is based on conservative values that will guarantee that the components always exceed the specification. For design purposes it is usually better to work with typical values. Since this data is not always available it is a good practice to measure the Capacitance and ESR values of Cin and Cout, and the inductance and DC resistance of L1 before assembly of the board. Any large discrepancies in values should be electrically simulated in WEBENCH to check for instabilities and thermally simulated in WebTHERM to make sure critical temperatures are not exceeded.

## Soldering Component to Board

If board assembly is done in house it is best to tack down one terminal of a component on the board then solder the other terminal. For surface mount parts with large tabs, such as the DPAK, the tab on the back of the package should be pre-tinned with solder, then tacked into place by one of the pins. To solder the tab town to the board place the iron down on the board while resting against the tab, heating both surfaces simultaneously. Apply light pressure to the top of the plastic case until the solder flows around the part and the part is flush with the PCB. If the solder is not flowing around the board you may need a higher wattage iron (generally 25W to 30W is enough).

## Initial Startup of Circuit

It is best to initially power up the board by setting the input supply voltage to the lowest operating input voltage 4.5V and set the input supply's current limit to zero. With the input supply off connect up the input supply to Vin and GND. Connect a digital volt meter and a load if needed to set the minimum Iout of the design from Vout and GND. Turn on the input supply and slowly turn up the current limit on the input supply. If the voltage starts to rise on the input supply continue increasing the input supply current limit while watching the output voltage. If the current increases on the input supply, but the voltage remains near zero, then there may be a short or a component misplaced on the board. Power down the board and visually inspect for solder bridges and recheck the diode and capacitor polarities. Once the power supply circuit is operational then more extensive testing may include full load testing, transient load and line tests to compare with simulation results.

## Load Testing

The setup is the same as the initial startup, except that an additional digital voltmeter is connected between Vin and GND, a load is connected between Vout and GND and a current meter is connected in series between Vout and the load. The load must be able to handle at least rated output power + 50% ( 7.5 watts for this design). Ideally the load is supplied in the form of a variable load test unit. It can also be done in the form of suitably large power resistors. When using an oscilloscope to measure waveforms on the prototype board, the ground leads of the oscilloscope probes should be as short as possible and the area of the loop formed by the ground lead should be kept to a minimum. This will help reduce ground lead inductance and eliminate EMI noise that is not actually present in the circuit.

## Design Assistance

1. Master key : F74A8A8BF9BD65A9C54D6D115824F2F9[v1]
2. LM2585 Product Folder : http://www.ti.com/product/LM2585 : contains the data sheet and other resources.

Copyright © 2022, Texas Instruments Incorporated | 8 | ti.com/webench

Important Notice and Disclaimer

TI provides technical and reliability data (including datasheets), design resources (including reference designs), application or other design advice, web tools, safety information, and other resources AS IS and with all faults, and disclaims all warranties. These resources are intended for skilled developers designing with TI products. You are solely responsible for (1) selecting the appropriate TI products for your application, (2) designing, validating and testing your application, and (3) ensuring your application meets applicable standards, and any other safety, security, or other requirements.

These resources are subject to change without notice. TI grants you permission to use these resources only for development of an application that uses the TI products described in the resource. Other reproduction and display of these resources is prohibited. No license is granted to any other TI intellectual property right or to any third party intellectual property right. TI disclaims responsibility for, and you will fully indemnify TI and its representatives against, any claims, damages, costs, losses, and liabilities arising out of your use of these resources.

Providing these resources does not expand or otherwise alter TI's applicable Terms of Sale or other applicable terms available either on ti.com or provided in conjunction with TI products.
