CaptnSisko/CHARM/hardware/node/node.kicad_pcb

## KiCad design hardware/node/node.kicad_pcb (2022-10-24)

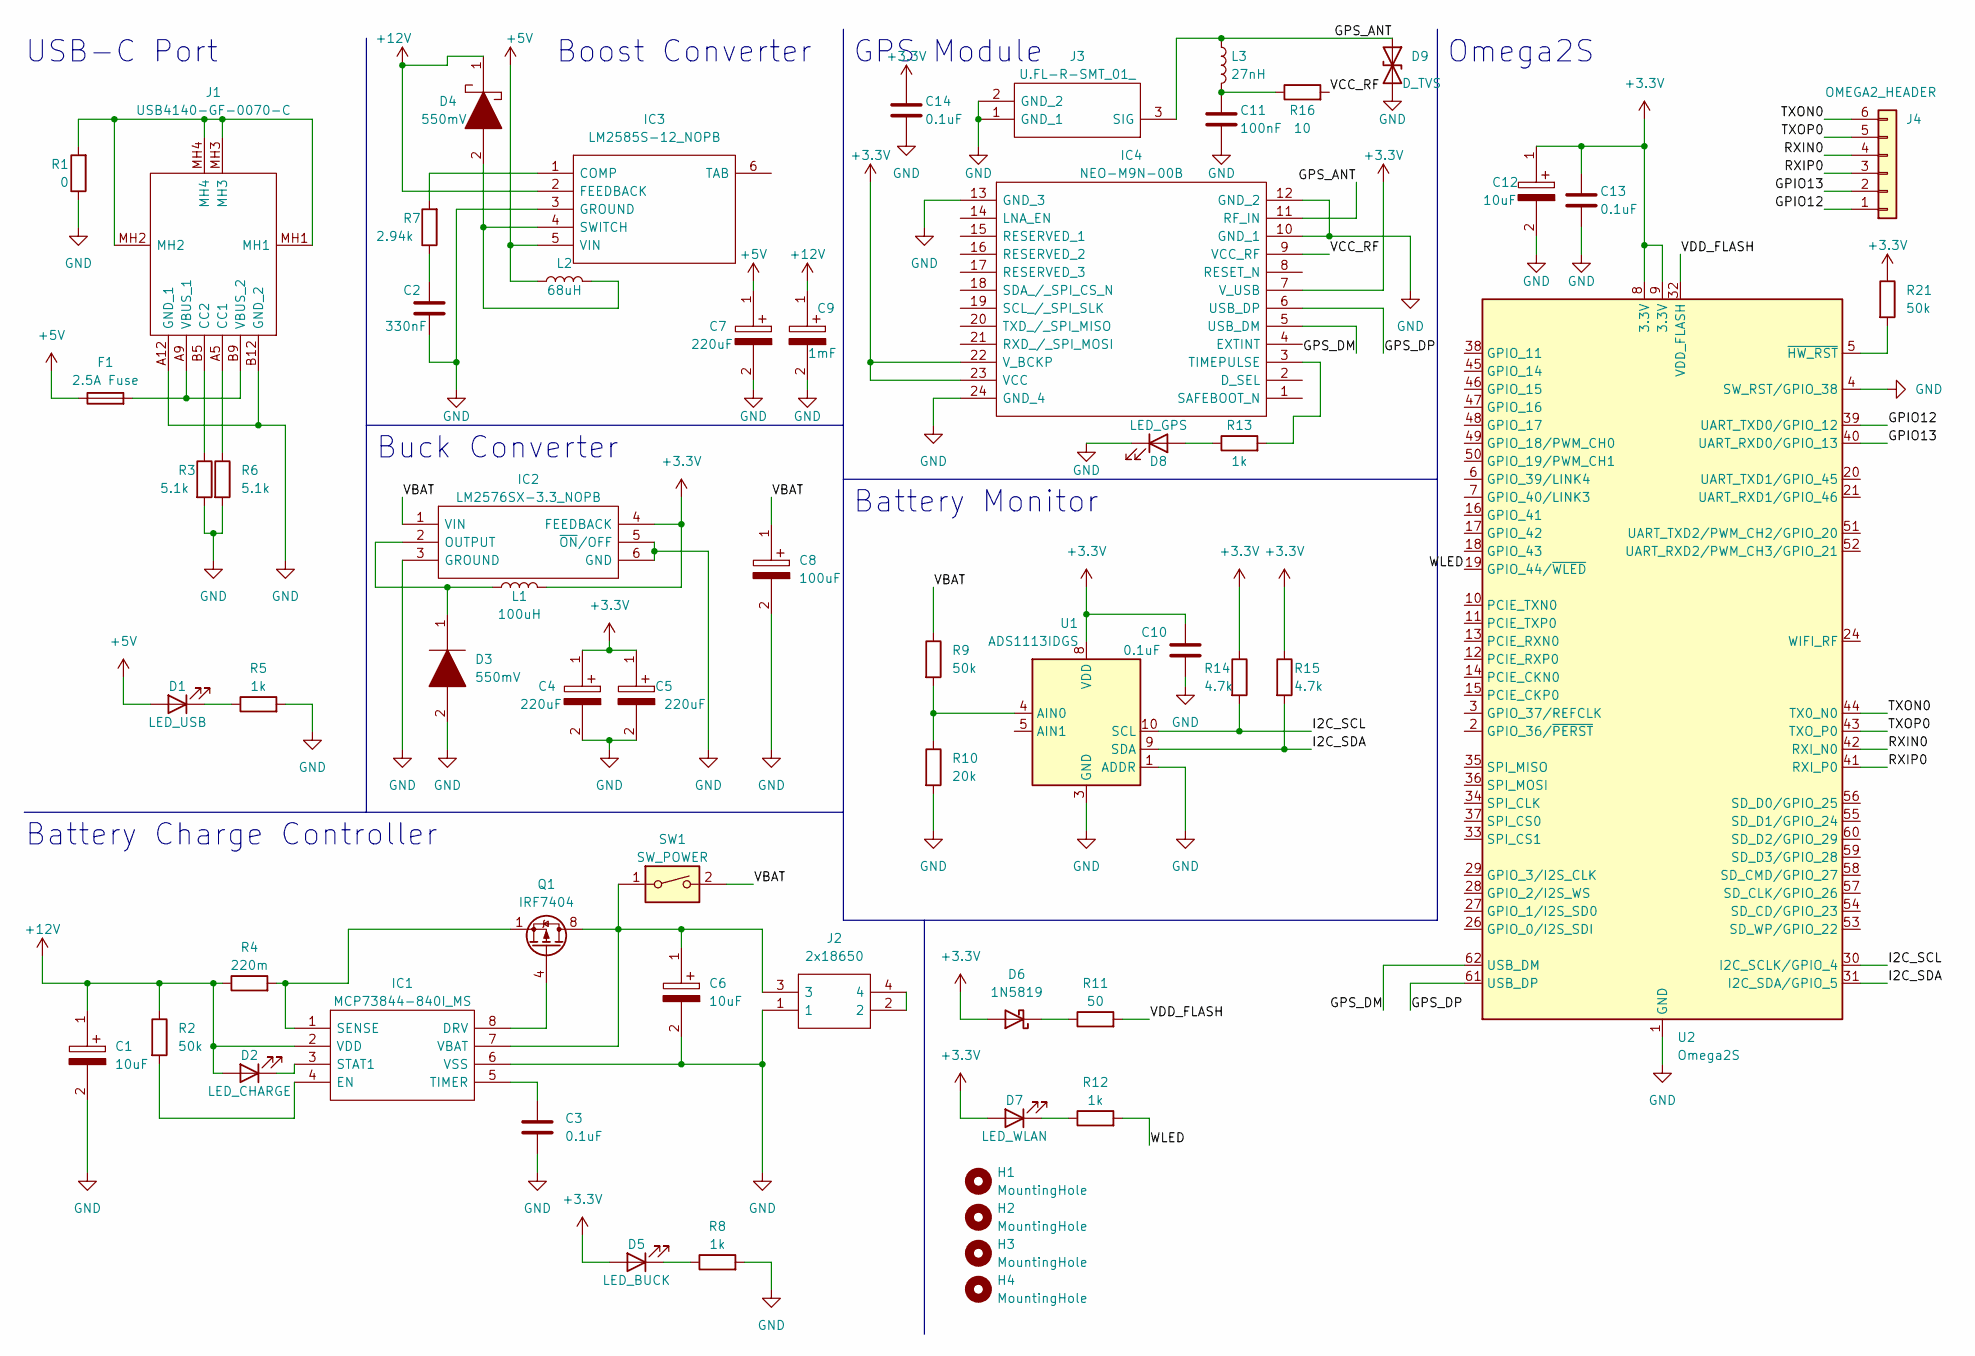
[picture p53: schematic node.kicad_sch]

Parts:
C1, C6, C12: 10uF; EEE1AA220WR; Manufacturer_Part_Number EEE-FN1E100R; Mouser Part Number 667-EEE-FN1E100R
C2: 330nF; C_1206_3216Metric_Pad1.33x1.80mm_HandSolder
C3, C10, C13, C14: 0.1uF; C_1206_3216Metric_Pad1.33x1.80mm_HandSolder
C4, C5, C7: 220uF; CAPAE660X800N; Manufacturer_Part_Number UUD1C221MCL1GS; Mouser Part Number 647-UUD1C221MCL
C8: 100uF; 16SVF180M; Manufacturer_Part_Number 16SVPC100M; Mouser Part Number 667-16SVPC100M
C9: 1mF; 16SVF1000M; Manufacturer_Part_Number 16SVPF1000M; Mouser Part Number 667-16SVPF1000M
C11: 100nF; C_0402_1005Metric_Pad0.74x0.62mm_HandSolder
D1: LED_USB; LED_0805_2012Metric_Pad1.15x1.40mm_HandSolder
D2: LED_CHARGE; LED_0805_2012Metric_Pad1.15x1.40mm_HandSolder
D3: 550mV; DIOM7959X250N; Manufacturer_Part_Number B520C-13-F; Mouser Part Number 621-B520C-F
D4: 550mV; SODFL3617X108N; Manufacturer_Part_Number SS24FL; Mouser Part Number 512-SS24FL
D5: LED_BUCK; LED_0805_2012Metric_Pad1.15x1.40mm_HandSolder
D6: 1N5819; D_A-405_P10.16mm_Horizontal
D7: LED_WLAN; LED_0805_2012Metric_Pad1.15x1.40mm_HandSolder
D8: LED_GPS; LED_0805_2012Metric_Pad1.15x1.40mm_HandSolder
D9: D_TVS; D_SOD-523
F1: 2.5A Fuse; Fuse_1206_3216Metric_Pad1.42x1.75mm_HandSolder
H1, H2, H3, H4: MountingHole; MountingHole_3.2mm_M3
IC1: MCP73844-840I_MS; SOP65P490X110-8N; Manufacturer_Part_Number MCP73844-840I/MS; Mouser Part Number 579-MCP73844-840I/MS
IC2: LM2576SX-3.3_NOPB; KTT0005B; Manufacturer_Part_Number LM2576SX-3.3/NOPB; Mouser Part Number 926-LM2576SX33NOPB
IC3: LM2585S-12_NOPB; TO170P1435X465-6N; Manufacturer_Part_Number LM2585S-12/NOPB; Mouser Part Number 926-LM2585S-12/NOPB
IC4: NEO-M9N-00B; NEOM9N00B; Manufacturer_Part_Number NEO-M9N-00B; Mouser Part Number 377-NEO-M9N-00B
J1: USB4140-GF-0070-C; USB4140GF0070C; Manufacturer_Part_Number USB4140-GF-0070-C; Mouser Part Number 640-USB4140-GF-0070C
J2: 2x18650; 1123; Manufacturer_Part_Number 1123; Mouser Part Number 534-1123
J3: U.FL-R-SMT_01_; UFLRSMT01; Manufacturer_Part_Number U.FL-R-SMT(01); Mouser Part Number 798-U.FL-R-SMT01
J4: OMEGA2_HEADER; PinSocket_1x06_P2.00mm_Vertical
L1: 100uH; 74437429203101
L2: 68uH; INDPM120120X1020N
L3: 27nH; L_0603_1608Metric_Pad1.05x0.95mm_HandSolder
Q1: IRF7404; SOIC-8_3.9x4.9mm_P1.27mm
R1: 0; R_0603_1608Metric_Pad0.98x0.95mm_HandSolder
R2, R9, R21: 50k; R_0603_1608Metric_Pad0.98x0.95mm_HandSolder
R3, R6: 5.1k; R_0603_1608Metric_Pad0.98x0.95mm_HandSolder
R4: 220m; R_0805_2012Metric_Pad1.20x1.40mm_HandSolder
R5, R8, R12, R13: 1k; R_0603_1608Metric_Pad0.98x0.95mm_HandSolder
R7: 2.94k; R_0603_1608Metric_Pad0.98x0.95mm_HandSolder
R10: 20k; R_0603_1608Metric_Pad0.98x0.95mm_HandSolder
R11: 50; R_0603_1608Metric_Pad0.98x0.95mm_HandSolder
R14, R15: 4.7k; R_0603_1608Metric_Pad0.98x0.95mm_HandSolder
R16: 10; R_1206_3216Metric_Pad1.30x1.75mm_HandSolder
SW1: SW_POWER; CKC5106-ND
U1: ADS1113IDGS; TSSOP-10_3x3mm_P0.5mm
U2: Omega2S; Onion_Omega2S

Connections:
+3.3V: C4.1, C5.1, C10.1, C12.1, C13.1, C14.1, D5.2 (A), D6.2 (A), D7.2 (A), IC2.4 (FEEDBACK), IC4.7 (V_USB), IC4.22 (V_BCKP), IC4.23 (VCC), L1.2, R14.1, R15.1, R21.1, U1.8 (VDD), U2.8 (3.3V), U2.9 (3.3V)
+5V: C7.1, D1.2 (A), F1.1, IC3.5 (VIN), L2.1
+12V: C1.1, C9.1, D2.2 (A), D4.1, IC1.2 (VDD), IC3.2 (FEEDBACK), R2.1, R4.1
/GPIO12: J4.1, U2.39 (UART_TXD0/GPIO_12)
/GPIO13: J4.2, U2.40 (UART_RXD0/GPIO_13)
/GPS_ANT: D9.1 (A1), IC4.11 (RF_IN), J3.3 (SIG), L3.1
/GPS_DM: IC4.5 (USB_DM), U2.62 (USB_DM)
/GPS_DP: IC4.6 (USB_DP), U2.61 (USB_DP)
/I2C_SCL: R14.2, U1.10 (SCL), U2.30 (I2C_SCLK/GPIO_4)
/I2C_SDA: R15.2, U1.9 (SDA), U2.31 (I2C_SDA/GPIO_5)
/RXIN0: J4.4, U2.42 (RXI_N0)
/RXIP0: J4.3, U2.41 (RXI_P0)
/TXON0: J4.6, U2.44 (TX0_N0)
/TXOP0: J4.5, U2.43 (TXO_P0)
/VBAT: C8.1, IC2.1 (VIN), R9.1, SW1.2
/VCC_RF: IC4.9 (VCC_RF), R16.2
/VDD_FLASH: R11.2, U2.32 (VDD_FLASH)
/WLED: R12.2, U2.19 (GPIO_44/~WLED)
GND: C1.2, C2.2, C3.2, C4.2, C5.2, C6.2, C7.2, C8.2, C9.2, C10.2, C11.2, C12.2, C13.2, C14.2, D3.2, D8.1 (K), D9.2 (A2), IC1.6 (VSS), IC2.3 (GROUND), IC2.5 (~ON/OFF), IC2.6 (GND), IC3.3 (GROUND), IC4.10 (GND_1), IC4.12 (GND_2), IC4.13 (GND_3), IC4.24 (GND_4), J1.A12 (GND_1), J1.B12 (GND_2), J2.1, J3.1 (GND_1), J3.2 (GND_2), R1.1, R3.2, R5.2, R6.2, R8.2, R10.2, U1.1 (ADDR), U1.3 (GND), U2.1 (GND), U2.4 (SW_RST/GPIO_38), U2.22 (GND), U2.23 (GND), U2.25 (GND), U2.63 (GND), U2.64 (GND)
unnamed: C2.1, R7.1
unnamed: C3.1, IC1.5 (TIMER)
unnamed: C6.1, IC1.7 (VBAT), J2.3, Q1.5 (D), Q1.6 (D), Q1.7 (D), Q1.8 (D), SW1.1
unnamed: C11.1, L3.2, R16.1
unnamed: D1.1 (K), R5.1
unnamed: D2.1 (K), IC1.3 (STAT1)
unnamed: D3.1, IC2.2 (OUTPUT), L1.1
unnamed: D4.2, IC3.4 (SWITCH), L2.2
unnamed: D5.1 (K), R8.1
unnamed: D6.1 (K), R11.1
unnamed: D7.1 (K), R12.1
unnamed: D8.2 (A), R13.1
unnamed: F1.2, J1.A9 (VBUS_1), J1.B9 (VBUS_2)
unnamed: IC1.1 (SENSE), Q1.1 (S), Q1.2 (S), Q1.3 (S), R4.2
unnamed: IC1.4 (EN), R2.2
unnamed: IC1.8 (DRV), Q1.4 (G)
unnamed: IC3.1 (COMP), R7.2
unnamed: IC4.3 (TIMEPULSE), R13.2
unnamed: J1.A5 (CC1), R6.1
unnamed: J1.B5 (CC2), R3.1
unnamed: J1.MH1, J1.MH2, J1.MH3, J1.MH4, R1.2
unnamed: J2.2, J2.4
unnamed: R9.2, R10.1, U1.4 (AIN0)
unnamed: R21.2, U2.5 (~HW_RST)

Notes on the sheet:
Boost Converter
Buck Converter
Battery Monitor
GPS Module
Battery Charge Controller
USB-C Port
Omega2S

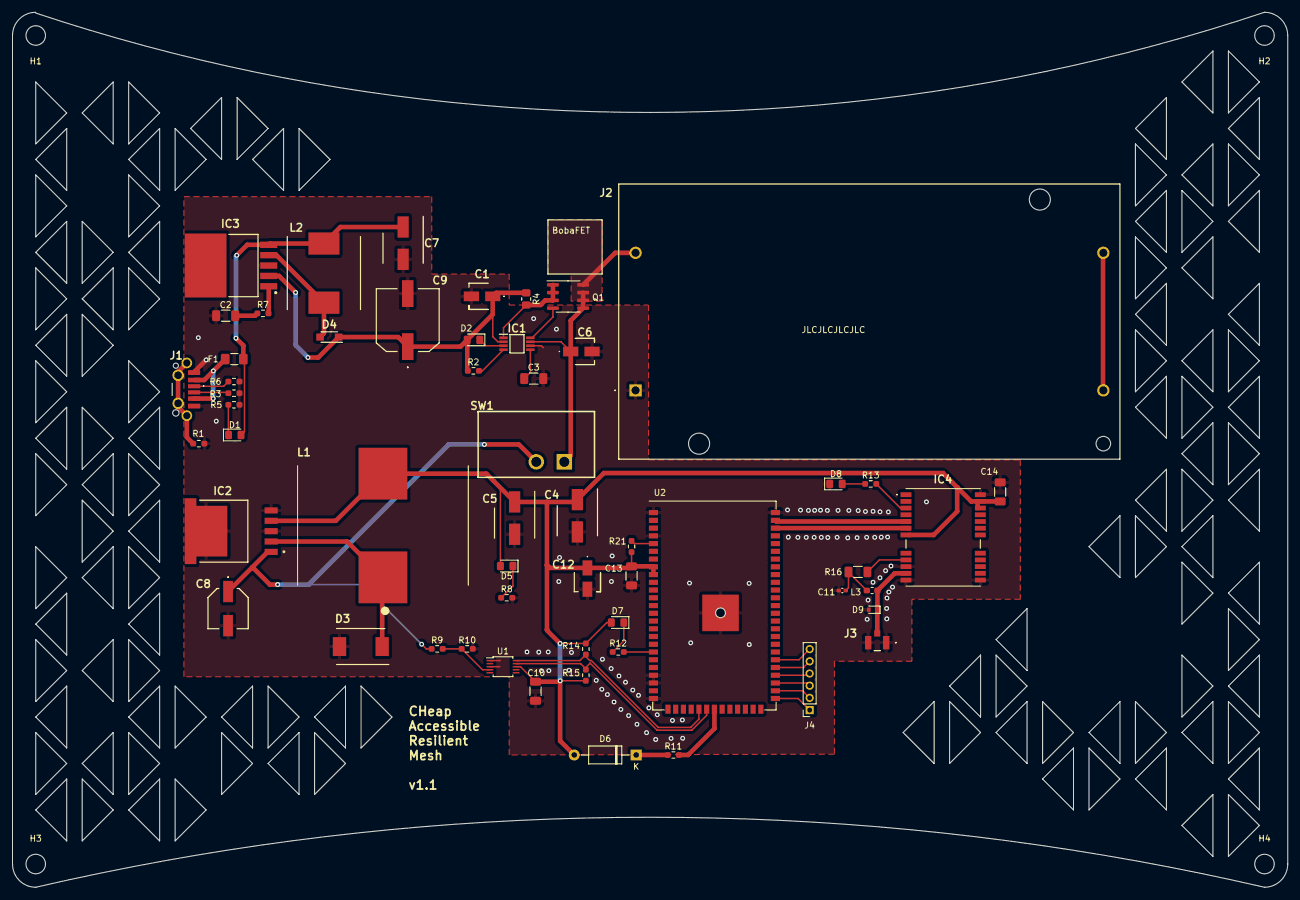
[picture p54: board node.kicad_pcb from above]

Board: 2 copper layers, 209.1 x 143.5 mm, 60 parts (0 on the bottom side), 43 nets.
