CaptnSisko/CHARM/(commit log)

2022-09-06 first half hardware notebook entry
    [node.kicad_pcb, node.kicad_sch]
2022-09-06 battery charge controller doc
2022-09-11 update to in-stock components
    [node_instock.kicad_sch]
2022-09-11 update boost converter
    [node_instock.kicad_sch]
2022-09-11 fix missing connection in boost converter
    [node_instock.kicad_sch]
2022-09-25 fix schematic naming, remove hard reset circuit
    [node.kicad_sch, node_old.kicad_sch]
2022-09-27 push latest hardware changes (TODO: active GPS antenna)
    [node.kicad_sch]
2022-09-27 import component footprints / symbols
    [node.kicad_sch]
2022-09-27 finish capacitor part selection and footprint assignment
    [node.kicad_sch]
2022-10-04 PCB Layout
    [node.kicad_pcb, node.kicad_sch]
2022-10-05 finalize PCB
    [node.kicad_sch]
2022-10-19 fix PCB dimensions to fit new case, remove USB series resistors from schematic
    [node.kicad_pcb, node.kicad_sch, node_old.kicad_pcb]
2022-10-19 push latest PCB
    [node.kicad_pcb]
2022-10-19 print database errors to console
2022-10-21 Finished ADC reading logic
2022-10-21 Data analysis on the ADC voltages
2022-10-21 Added data point from ADC with batteries
2022-10-23 Finished ADC analysis
2022-10-24 push some notebook
    [node.kicad_pcb]
2022-10-24 PCB Layout Sections
2022-10-24 add pcb layout to notebook
2022-10-25 Added charging system stress test information
2022-10-25 Added .tex file for the soldering guide ahead of PCB delivery
2022-10-25 Progress on battery soldering manual
2022-10-25 Finished section with buck converter
2022-10-25 Finished omega 2s+ soldering section
2022-10-26 Finished everything expcept for quality assurance in the soldering guide
2022-10-26 Finished my portion of the soldering guide
2022-11-06 Fixed bug in refactored code
    [gps.c, telemetry.c, test_telemetry.c]
2022-11-24 Finished telemetry raw scripts
    [adc_params.txt]
